drewsum/Stopwatch/README.md

# Stopwatch
Hardware stopwatch, no code or microcontroller. 

"Display Enable" pushbutton toggles the seven segment LED display on and off
"Count Reset" pushbutton resets the counted time back to 00:00:00
"Count Enable" pushbutton starts and stops the stopwatch
