drewsum/Stopwatch/hdw/rev_b/Stopwatch/Stopwatch-BOM.xlsx

Reference | Value | Datasheet | Footprint | Qty | DNP | Config | Digi-Key PN
C201,C303,C402,C601,C602,C603 | 10nF |  | Capacitors_SMD:C_0402 | 6 |  |  | 445-12201-1-ND
C202,C304,C401,C404,C405,C406,C501,C502,C503,C504,C505,C604,C605,C606,C610,C611,C612,C613,C614,C701,C801,C901,C1001,C1101,C1201,C1301,C1302,C1303,C1304,C1305,C1306,C1307,C1401,C1402,C1403,C1404,C1405,C1406,C1407 | 0.1uF |  | Capacitors_SMD:C_0402 | 39 |  |  | 490-10697-1-ND
C203 | 100uF |  | Capacitor_Tantalum_SMD:CP_EIA-7343-43_Kemet-X | 1 |  |  | 718-1102-1-ND
C301,C305,C306 | 10uF |  | Capacitors_SMD:C_1206 | 3 |  |  | 1276-7031-1-ND
C302,C607,C608,C609 | 10uF |  | Capacitors_SMD:C_0402 | 4 |  |  | 490-GRM155R61A106ME11DCT-ND
C403 | 1nF |  | Capacitors_SMD:C_0402 | 1 |  |  | 445-7376-1-ND
D201 | 24V | ~ | Diodes_SMD:D_SMA | 1 | DNP | DNP | SMAJ24CALFCT-ND
D301 | BAT48JFILM | www.st.com/resource/en/datasheet/bat48.pdf | Diode_SMD:D_SOD-323 | 1 |  |  | 497-5711-1-ND
D501,D504,D505 | Green | ~ | LEDs:LED_0402 | 3 |  |  | 754-1101-1-ND
D502,D503,D506,D507 | Red | ~ | LEDs:LED_0402 | 4 |  |  | 754-1104-1-ND
H1501,H1502,H1503,H1504 | 3mm | ~ | MountingHole:MountingHole_3mm | 4
J201 | +12V IN | ~ | Connectors:BARREL_JACK | 1 |  |  | CP-202BH-ND
L301 | 2.2u |  | Inductors_SMD:L_Vishay_IHLP-2020 | 1 |  |  | 541-1236-1-ND
N201 | +12V 1A Power Supply | ~ |  | 1 |  |  | 993-1335-ND
Q301 | BSS214NW | https://www.infineon.com/dgdl/Infineon-BSS214NW-DS-v02_02-en.pdf?fileId=db3a30431b3e89eb011b695aebc01bde | Package_TO_SOT_SMD:SOT-323_SC-70 | 1 |  |  | BSS214NWH6327XTSA1CT-ND
Q302 | ZXMS6004FFTA | https://www.diodes.com/assets/Datasheets/ZXMS6004FF.pdf | Package_TO_SOT_SMD:SOT-23 | 1 |  |  | ZXMS6004FFCT-ND
R201 | 51.1k |  | Resistors_SMD:R_0402 | 1 |  |  | RMCF0402FT51K1CT-ND
R202 | 1.15k |  | Resistors_SMD:R_0402 | 1 |  |  | RMCF0402FT1K15CT-ND
R203,R207 | 5.11k |  | Resistors_SMD:R_0402 | 2 |  |  | RMCF0402FT5K11CT-ND
R204,R205,R208,R302,R303,R401,R402,R403,R404,R405,R406,R607,R608,R609,R610,R611,R612,R613,R614,R615,R616,R617,R701,R801,R901,R1001,R1101,R1201,R1301,R1302,R1303,R1304,R1305,R1306,R1307,R1401,R1402,R1403,R1404,R1405,R1406,R1407 | 10k |  | Resistors_SMD:R_0402 | 42 |  |  | RMCF0402FT10K0CT-ND
R206 | 13k |  | Resistors_SMD:R_0402 | 1 |  |  | RMCF0402FT13K0CT-ND
R301 | 10 |  | Resistors_SMD:R_0402 | 1 |  |  | RMCF0402FT10R0CT-ND
R304 | 562k |  | Resistors_SMD:R_0402 | 1 |  |  | RMCF0402FT562KCT-ND
R305 | 180k |  | Resistors_SMD:R_0402 | 1 |  |  | RMCF0402FT180KCT-ND
R501,R502,R503,R504,R505,R506,R507,R601,R602,R603,R604,R605,R606 | 1k |  | Resistors_SMD:R_0402 | 13 |  |  | RMCF0402FT1K00CT-ND
RN701,RN801,RN901,RN1001,RN1101,RN1201 | 1k |  | Resistor_SMD:R_Cat16-8 | 6 |  |  | CAT16-102J8LFCT-ND
SW601,SW602,SW603 | Cap_Touch |  | Custom Footprints Library:Capacitive_Touch_Pad | 3
TP201 | TP |  | Connector_PinHeader_2.54mm:PinHeader_1x01_P2.54mm_Horizontal | 1
TP202,TP203 | TP_Pad |  | Custom Footprints Library:Test_Point | 2
TP301 | TP |  | Custom Footprints Library:Test_Point | 1
U201 | TPS26600RHFT | http://www.ti.com/lit/ds/symlink/tps2660.pdf | Housings_DFN_QFN:QFN-24-1EP_4x5mm_Pitch0.5mm | 1 |  |  | 296-45478-1-ND
U301 | TPS62130A | http://www.ti.com/lit/ds/symlink/tps62130.pdf | Housings_DFN_QFN:QFN-16-1EP_3x3mm_Pitch0.5mm | 1 |  |  | 296-39446-1-ND
U401,U501,U502,U503,U504,U505,U604,U605,U606,U1301,U1302,U1303,U1304,U1305,U1306,U1307,U1401,U1402,U1403,U1404,U1405,U1406,U1407 | 74LVC1G97 | http://www.ti.com/lit/ds/symlink/sn74lvc1g97.pdf | Package_TO_SOT_SMD:SOT-363_SC-70-6 | 23 |  |  | 296-15582-1-ND
U402 | CD4024 | http://www.ti.com/lit/ds/symlink/cd4020b.pdf | Housings_SSOP:TSSOP-14_4.4x5mm_Pitch0.65mm | 1 |  |  | 296-49578-ND
U403 | CD4040 | http://www.intersil.com/content/dam/Intersil/documents/cd40/cd4020bms-24bms-40bms.pdf | Custom Footprints Library:DHVQFN16-1ep_3p5x2p5mm | 1 |  |  | 1727-7992-1-ND
U601,U602,U603 | AT42QT1010-TSHR | http://ww1.microchip.com/downloads/en/DeviceDoc/Atmel-9541-AT42-QTouch-BSW-AT42QT1010_Datasheet.pdf | TO_SOT_Packages_SMD:SOT-23-6 | 3 |  |  | AT42QT1010-TSHRCT-ND
U607,U608 | 74LVC1G80 | http://www.ti.com/lit/sg/scyt129e/scyt129e.pdf | Package_TO_SOT_SMD:SOT-353_SC-70-5 | 2 |  |  | 296-41824-1-ND
U701,U801,U901,U1001,U1101,U1201 | 4026 |  | Housings_SSOP:TSSOP-16_4.4x5mm_Pitch0.65mm | 6 |  |  | 296-32878-5-ND
U702,U802,U902,U1002,U1102,U1202 | HDSP-7503 | https://docs.broadcom.com/docs/AV02-2553EN | Display_7Segment:HDSP-A151 | 6 |  |  | 516-1203-5-ND
X401 | ECS-327KE |  | Oscillator:Oscillator_SMD_Abracon_ASE-4Pin_3.2x2.5mm | 1 |  |  | XC1751CT-ND
