drewsum/Stopwatch/hdw/rev_a/Stopwatch/Stopwatch.pdf

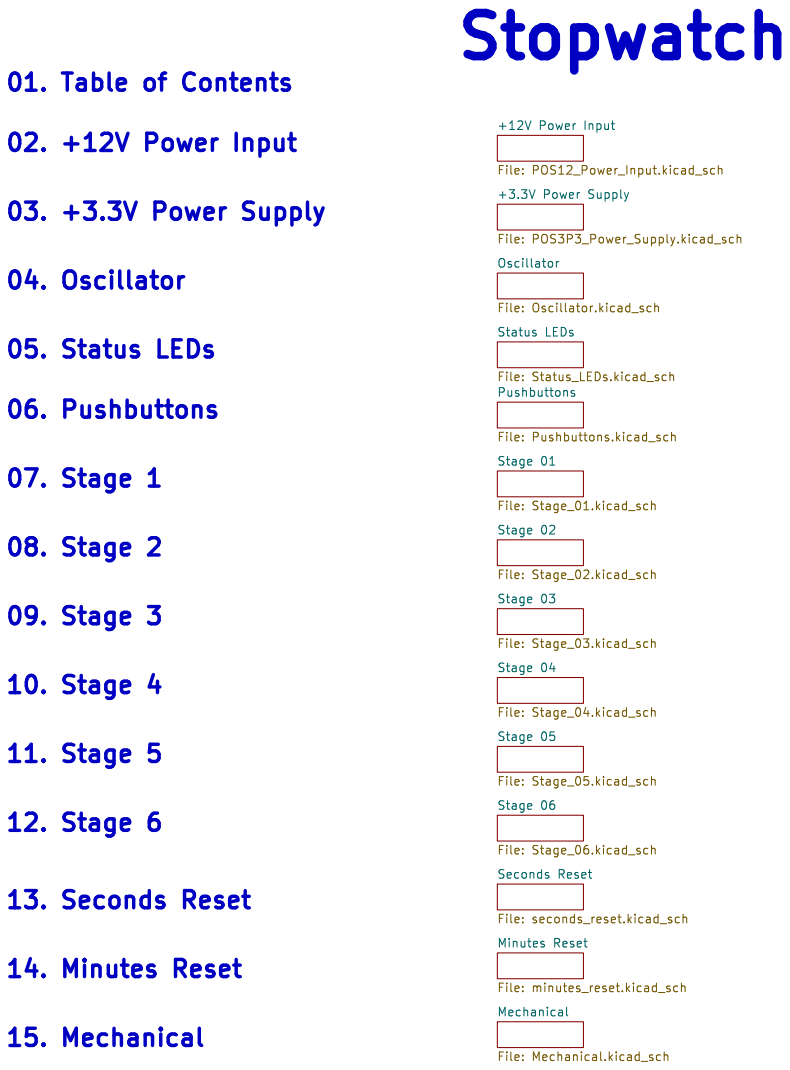
[picture p1: page 1]

Stage 01 File: Stage_01.kicad_sch Status LEDs File: Status_LEDs.kicad_sch Pushbuttons File: Pushbuttons.kicad_sch +3.3V Power Supply File: POS3P3_Power_Supply.kicad_sch +12V Power Input File: POS12_Power_Input.kicad_sch Oscillator File: Oscillator.kicad_sch Stage 02 File: Stage_02.kicad_sch

Stage 06 File: Stage_06.kicad_sch Mechanical File: Mechanical.kicad_sch Minutes Reset File: minutes_reset.kicad_sch Seconds Reset File: seconds_reset.kicad_sch 12. Stage 6

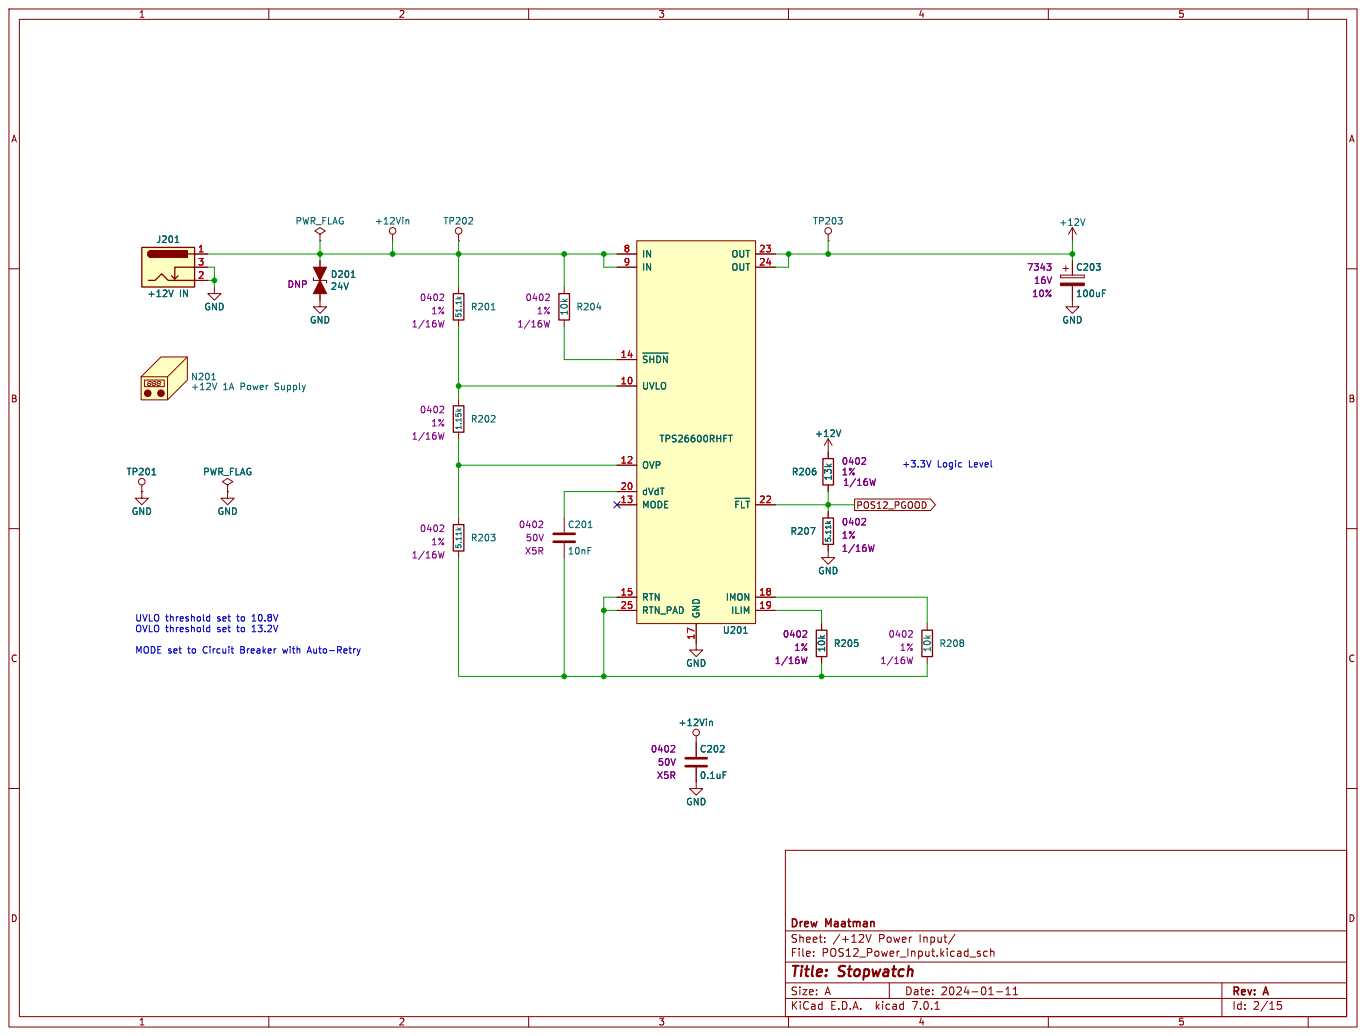
[picture p2: page 2]

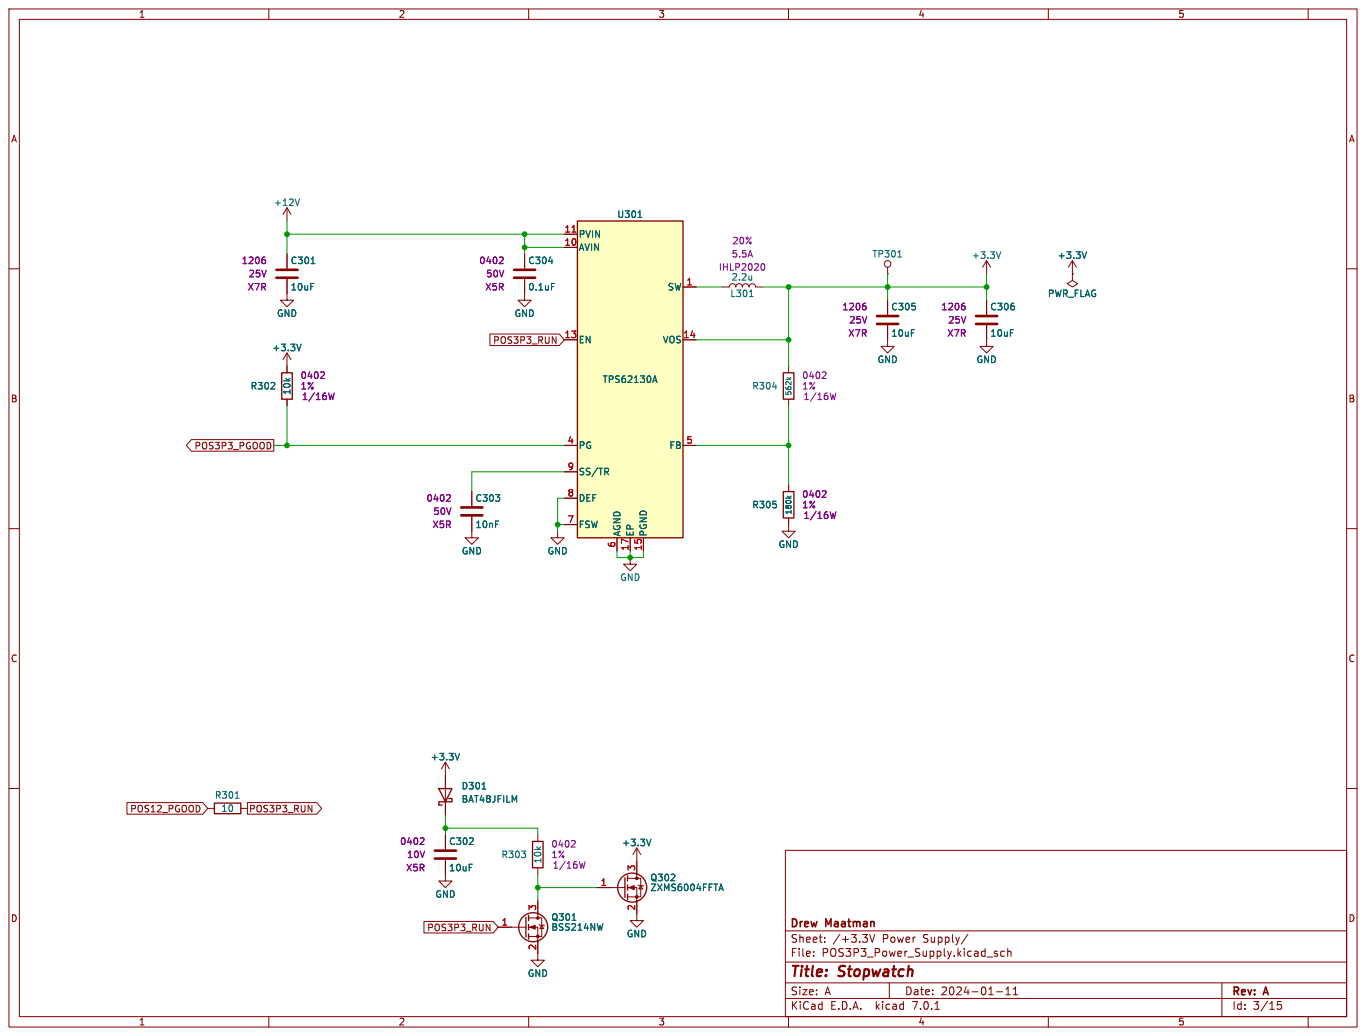
[picture p3: page 3]

6 FSW 7 DEF 8 SS/TR 9 U301 TPS62130A

6 FSW 7 DEF 8 SS/TR 9 C306

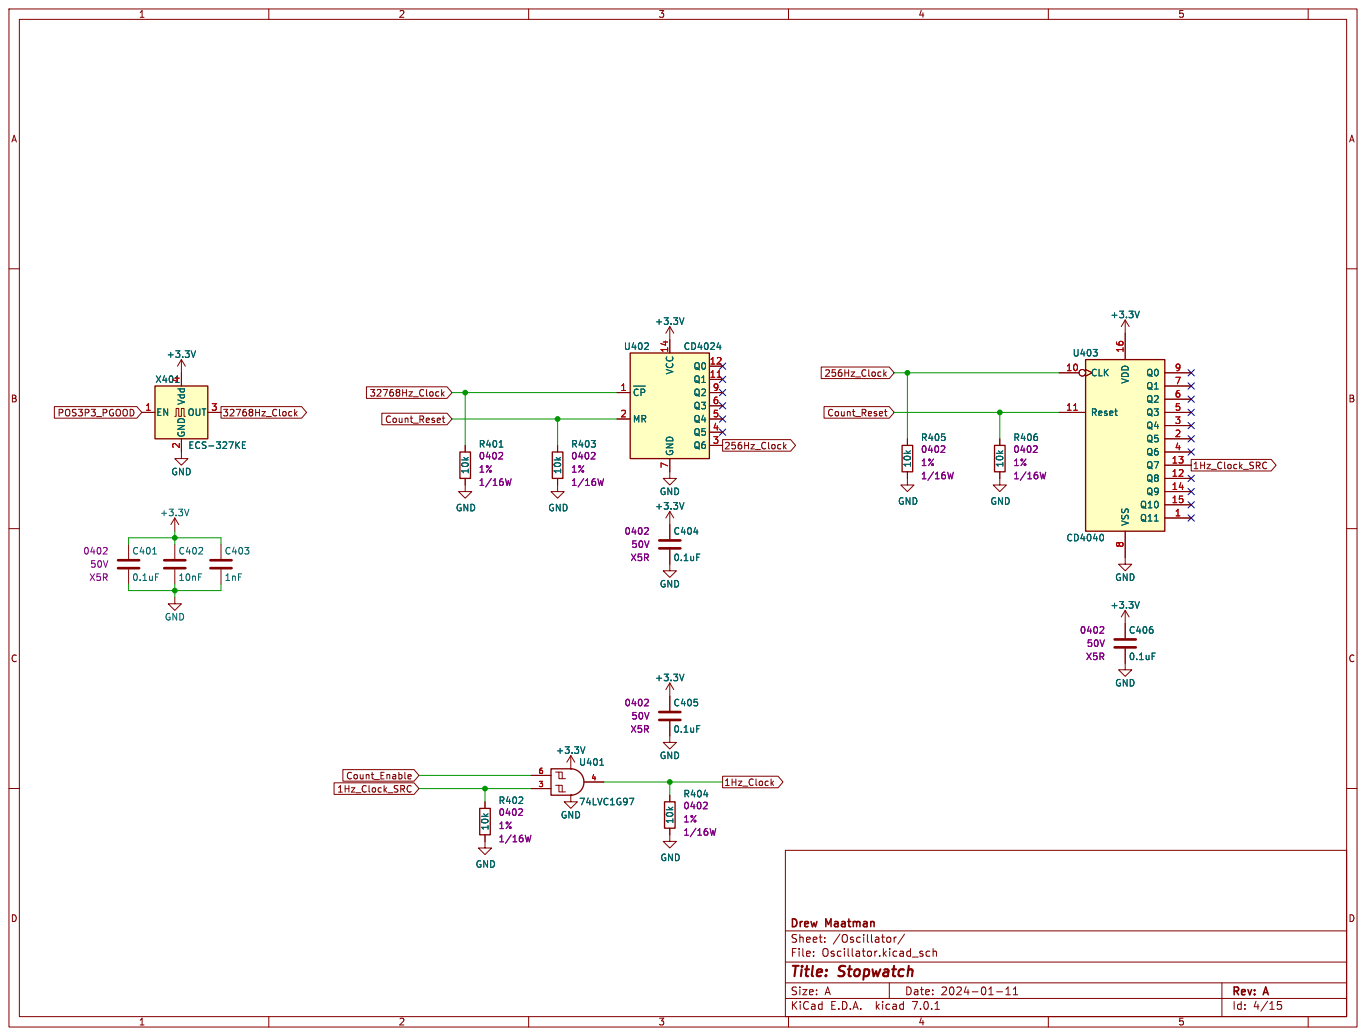
[picture p4: page 4]

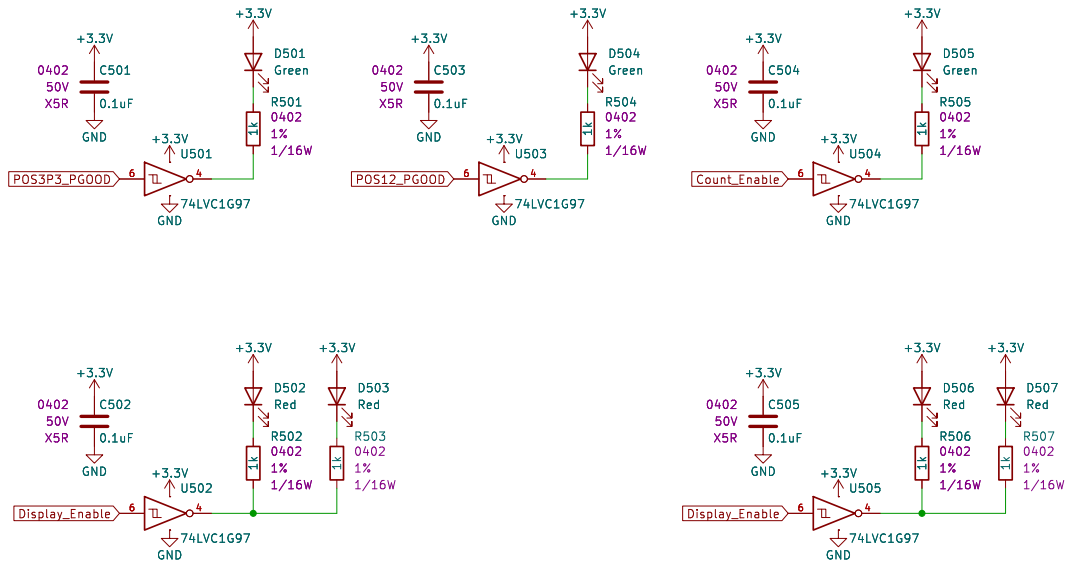
[picture p5: page 5]

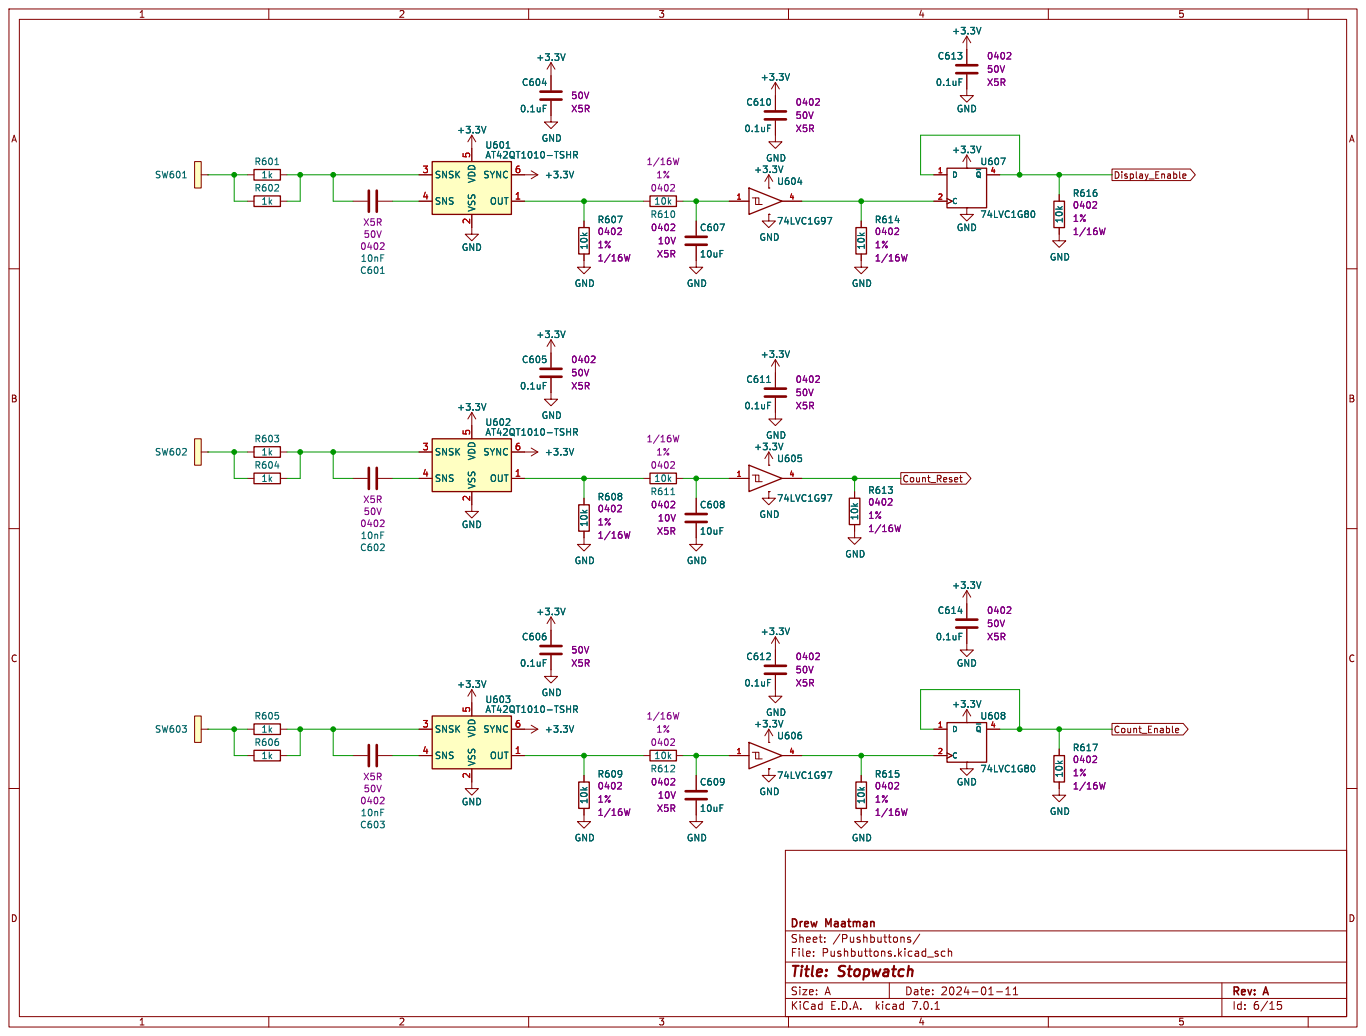
[picture p6: page 6]

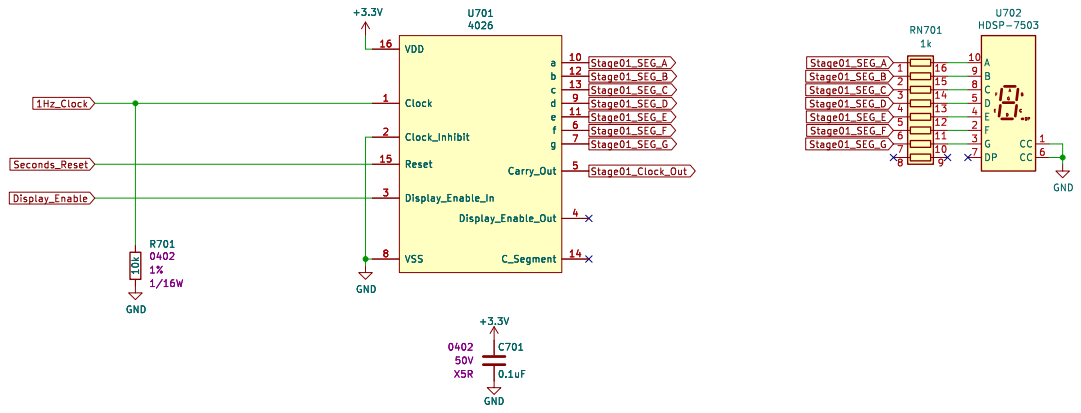
[picture p7: page 7]

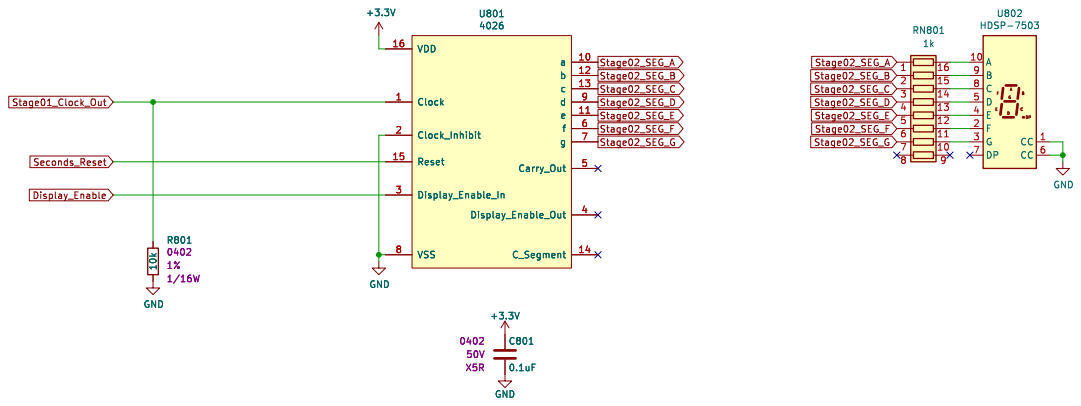
[picture p8: page 8]

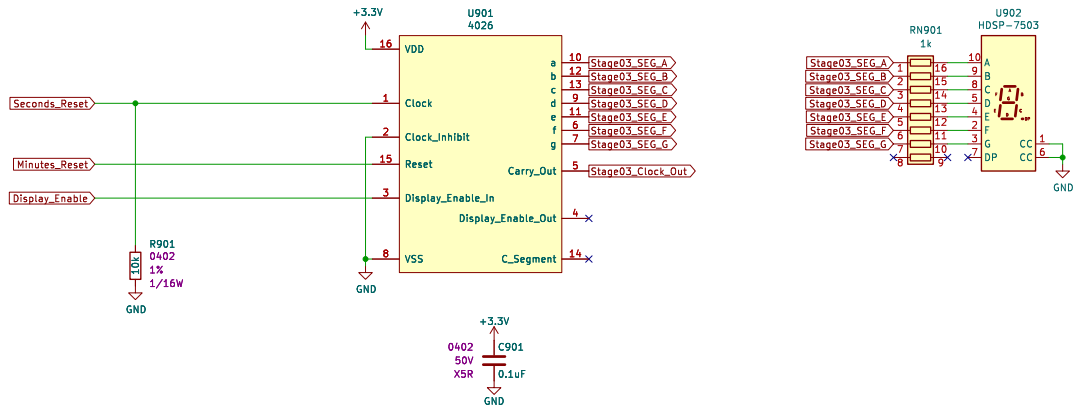
[picture p9: page 9]

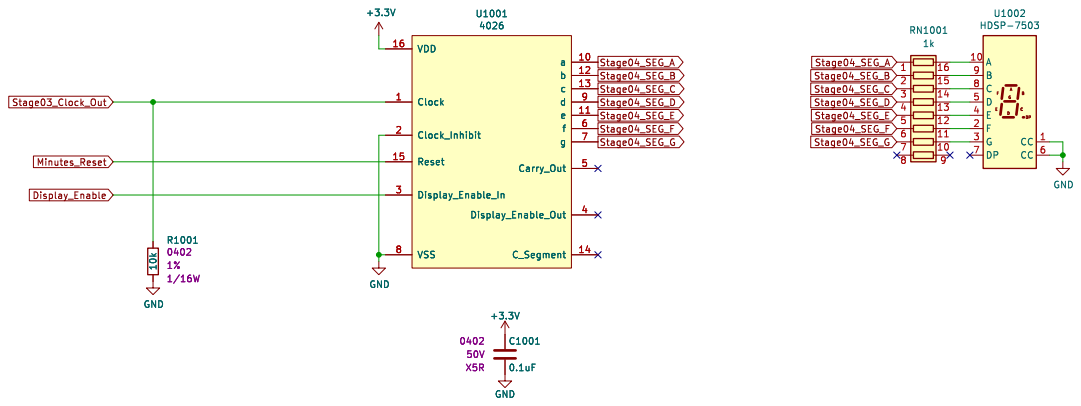
[picture p10: page 10]

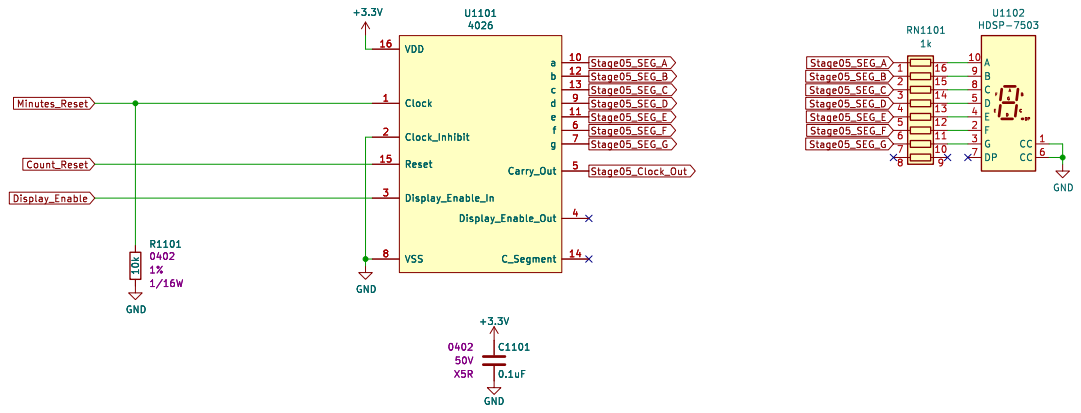
[picture p11: page 11]

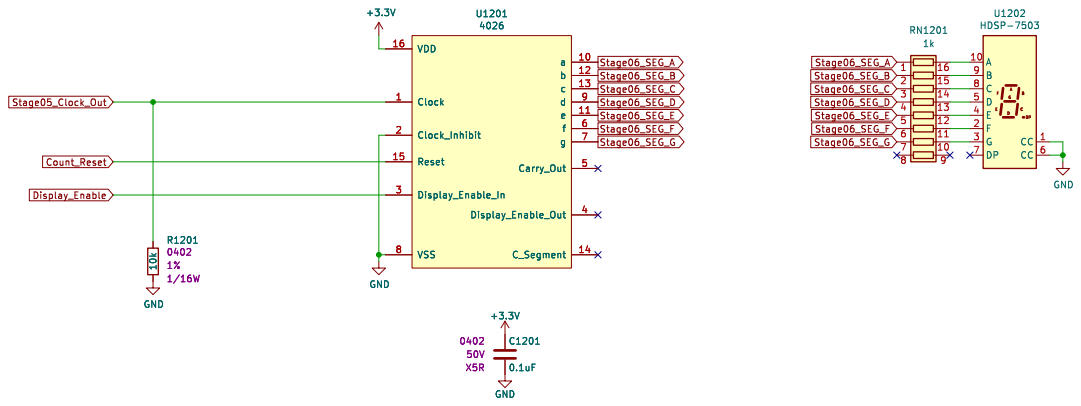
[picture p12: page 12]

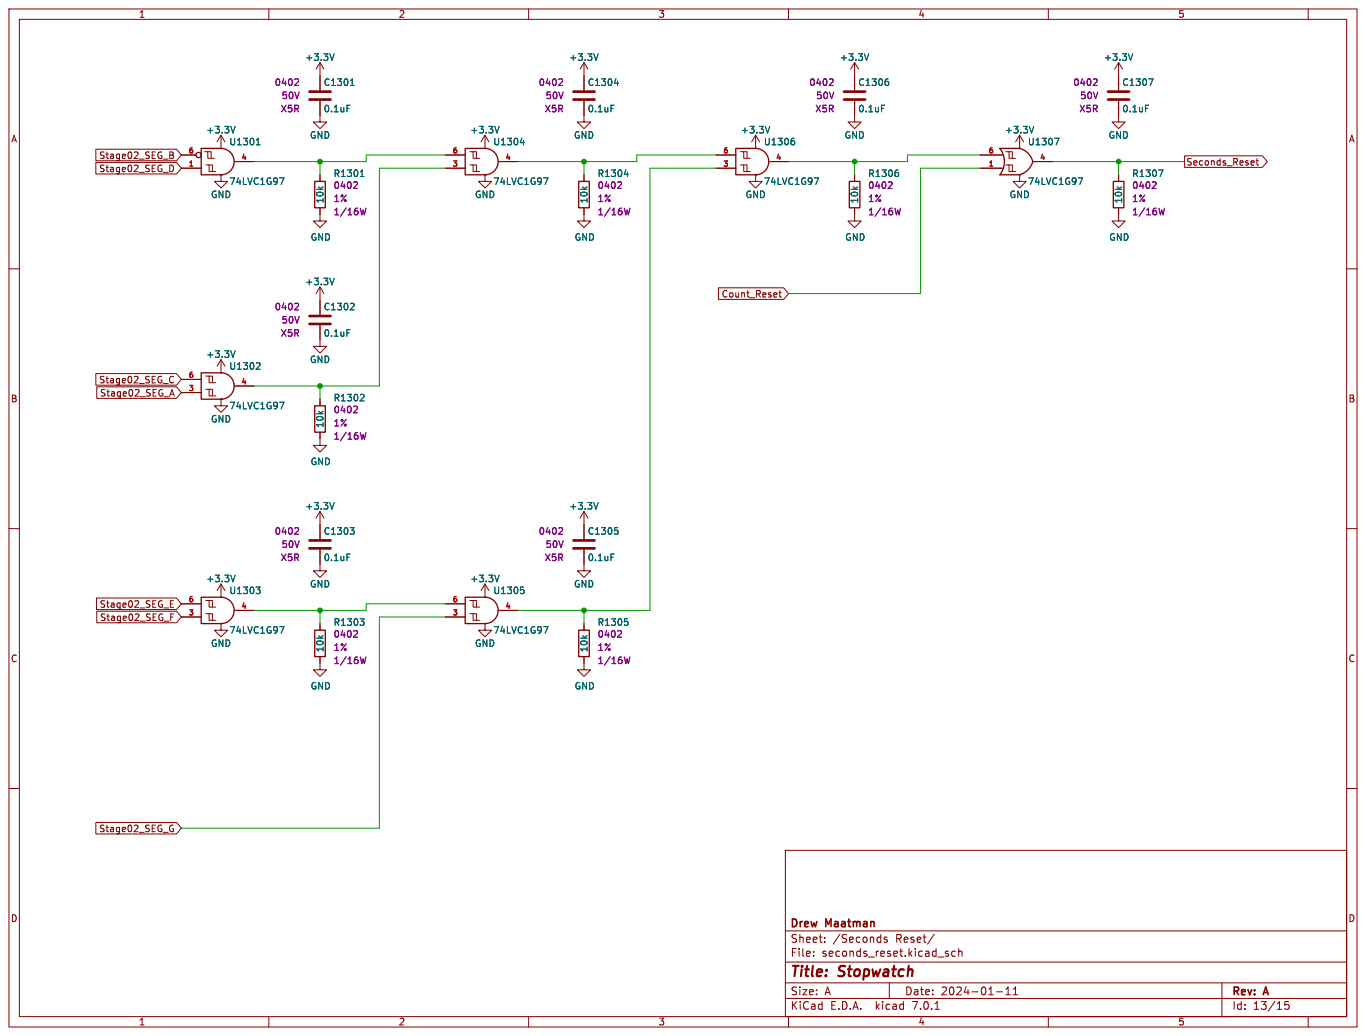
[picture p13: page 13]

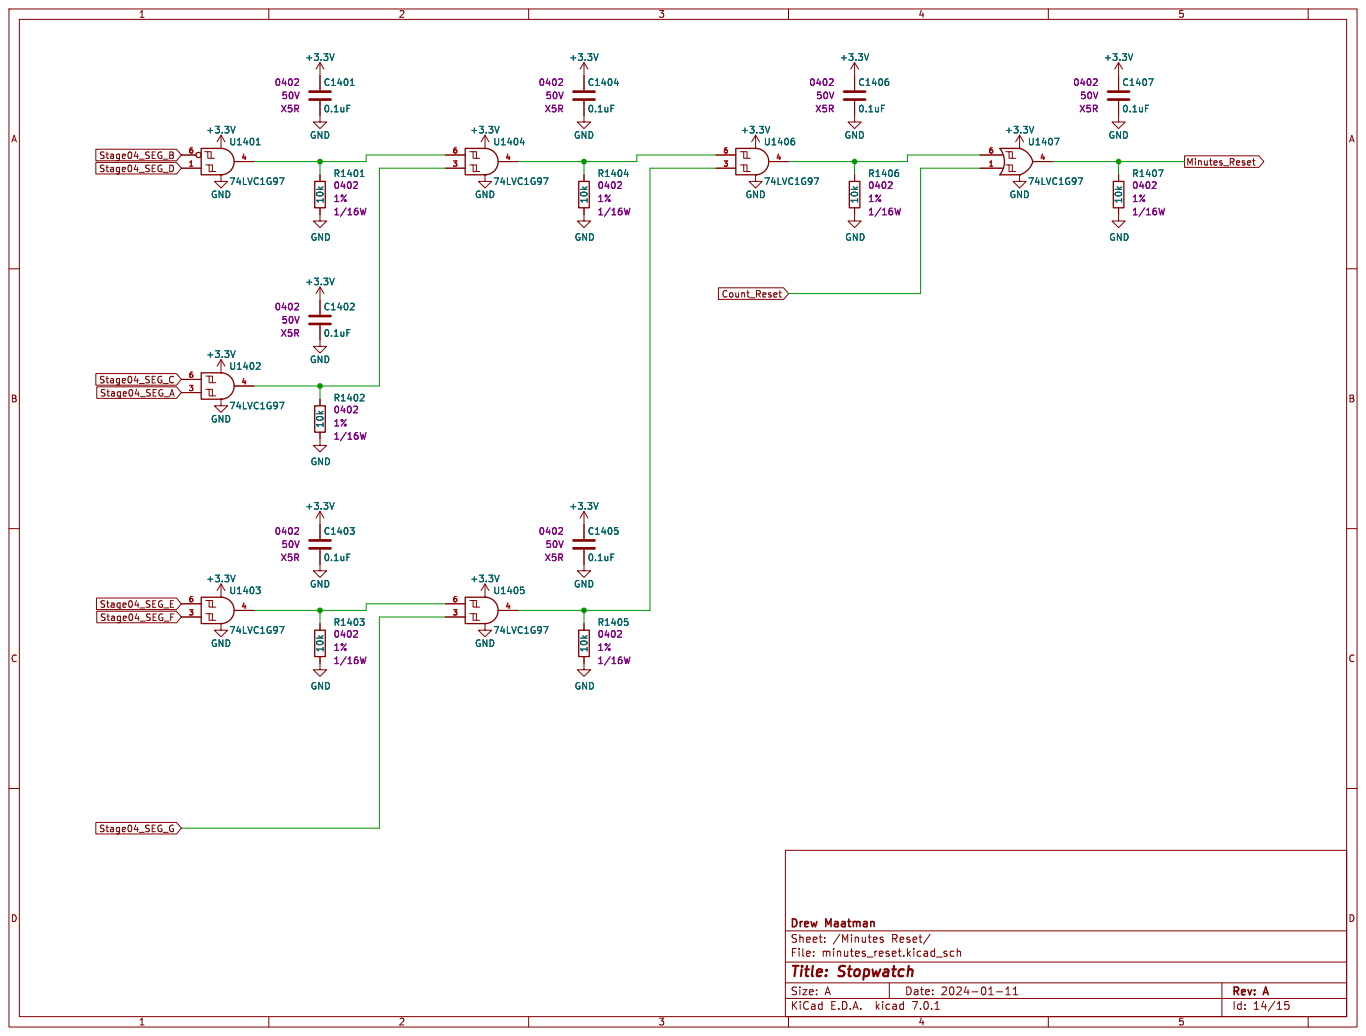
[picture p14: page 14]

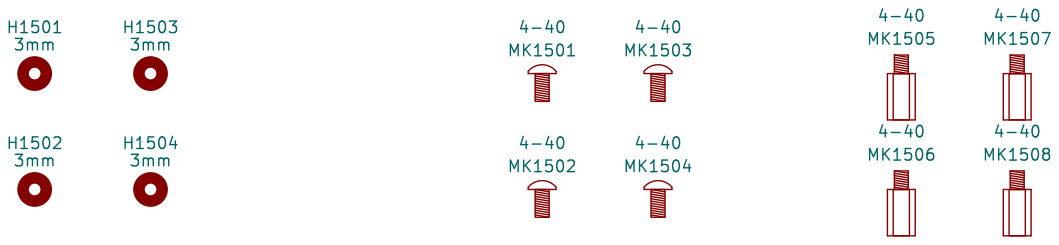
[picture p15: page 15]
