drewsum/Stopwatch/hdw/rev_a/Stopwatch/Stopwatch.kicad_pcb

## KiCad design hdw/rev_a/Stopwatch/Stopwatch.kicad_pcb (2024-02-03, an earlier design)

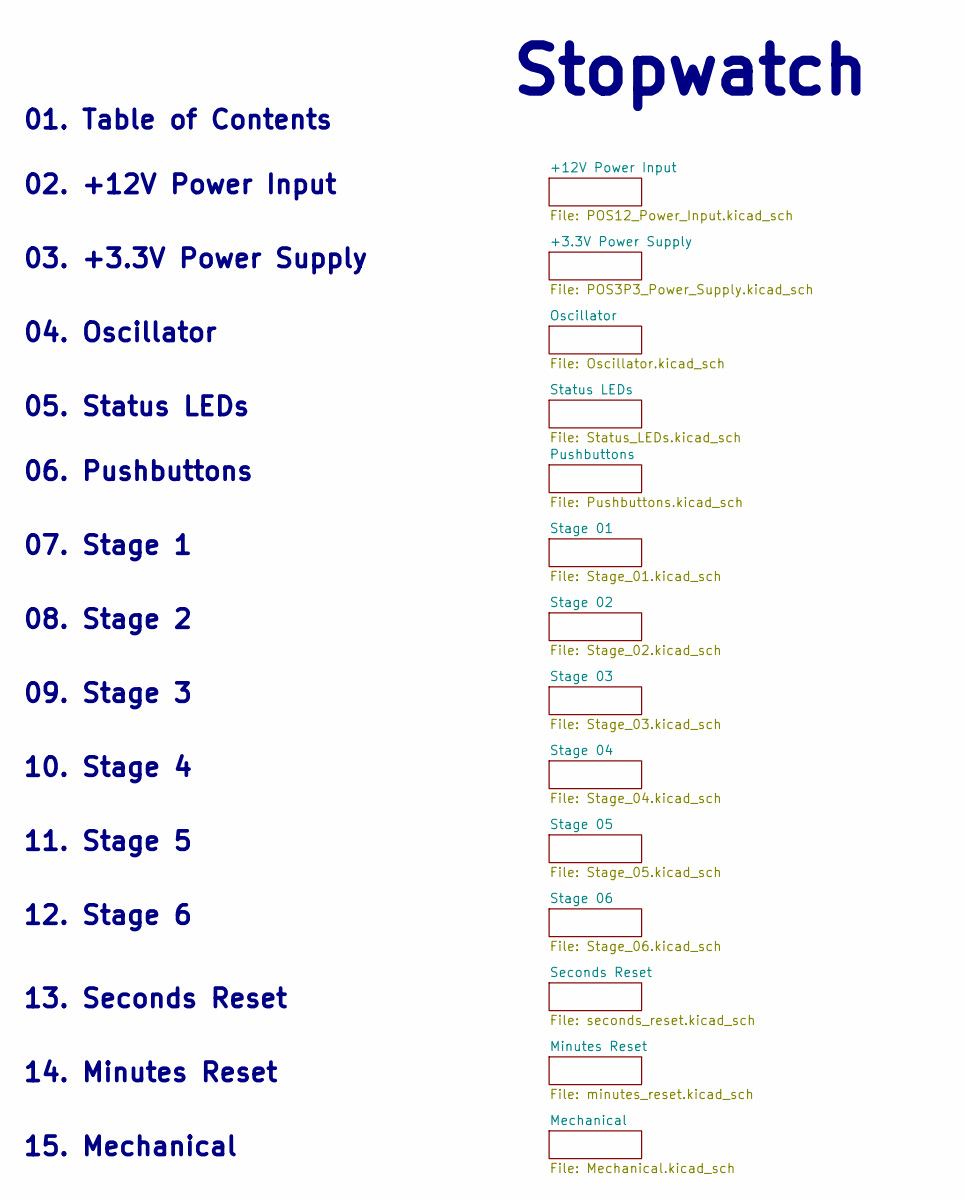
[picture p16: schematic Stopwatch.kicad_sch]

Notes on the sheet:
12. Stage 6
09. Stage 3
05. Status LEDs
10. Stage 4
15. Mechanical
Stopwatch
03. +3.3V Power Supply
01. Table of Contents
14. Minutes Reset
08. Stage 2
06. Pushbuttons
02. +12V Power Input
07. Stage 1
11. Stage 5
13. Seconds Reset
04. Oscillator

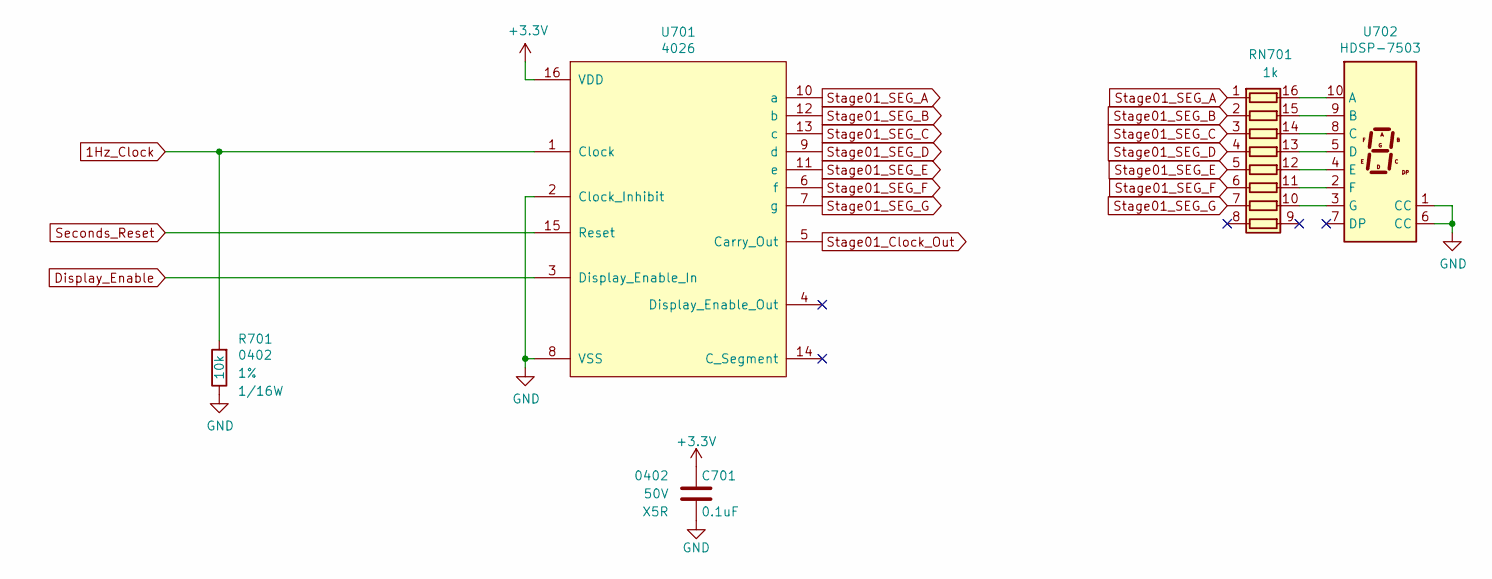
[picture p17: schematic Stage_01.kicad_sch, Stopwatch]

Parts:
C701: 0.1uF; C_0402; Voltage 50V; Digi-Key PN 490-10697-1-ND
R701: 10k; R_0402; Tolerance 1%; Digi-Key PN RMCF0402FT10K0CT-ND
RN701: 1k; R_Cat16-8; Digi-Key PN CAT16-102J8LFCT-ND
U701: 4026; TSSOP-16_4.4x5mm_Pitch0.65mm; Digi-Key PN 296-32878-5-ND
U702: HDSP-7503; HDSP-A151; Digi-Key PN 516-1203-5-ND

Connections:
1Hz_Clock: R701.1, U701.1 (Clock); also elsewhere on the board
+3.3V: C701.1, U701.16 (VDD); also elsewhere on the board
Display_Enable: U701.3 (Display_Enable_In); also elsewhere on the board
GND: C701.2, R701.2, U701.2 (Clock_Inhibit), U701.8 (VSS), U702.1 (CC), U702.6 (CC); also elsewhere on the board
unnamed: RN701.16 (R1.2), U702.10 (A)
unnamed: RN701.15 (R2.2), U702.9 (B)
unnamed: RN701.14 (R3.2), U702.8 (C)
unnamed: RN701.13 (R4.2), U702.5 (D)
unnamed: RN701.12 (R5.2), U702.4 (E)
unnamed: RN701.11 (R6.2), U702.2 (F)
unnamed: RN701.10 (R7.2), U702.3 (G)
Seconds_Reset: U701.15 (Reset); also elsewhere on the board
Stage01_Clock_Out: U701.5 (Carry_Out); also elsewhere on the board
Stage01_SEG_A: RN701.1 (R1.1), U701.10 (a)
Stage01_SEG_B: RN701.2 (R2.1), U701.12 (b)
Stage01_SEG_C: RN701.3 (R3.1), U701.13 (c)
Stage01_SEG_D: RN701.4 (R4.1), U701.9 (d)
Stage01_SEG_E: RN701.5 (R5.1), U701.11 (e)
Stage01_SEG_F: RN701.6 (R6.1), U701.6 (f)
Stage01_SEG_G: RN701.7 (R7.1), U701.7 (g)

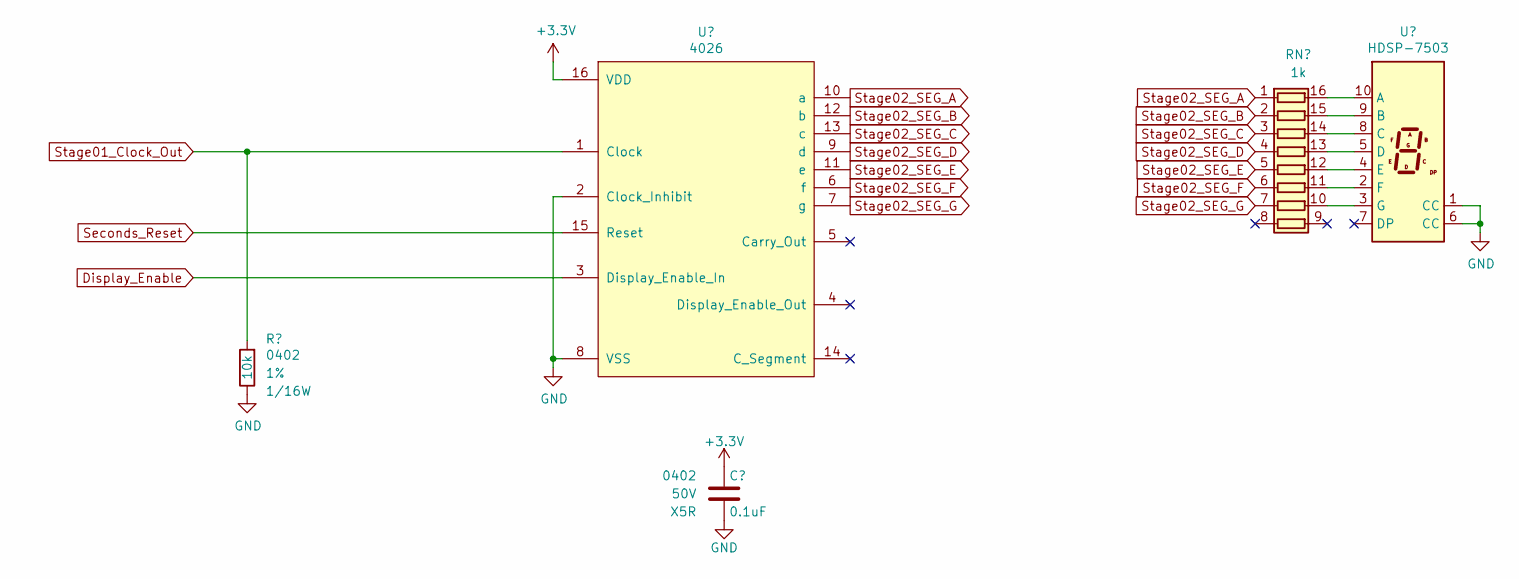
[picture p18: schematic Stage_02.kicad_sch, Stopwatch]

Parts:
C801: 0.1uF; C_0402; Voltage 50V; Digi-Key PN 490-10697-1-ND
R801: 10k; R_0402; Tolerance 1%; Digi-Key PN RMCF0402FT10K0CT-ND
RN801: 1k; R_Cat16-8; Digi-Key PN CAT16-102J8LFCT-ND
U801: 4026; TSSOP-16_4.4x5mm_Pitch0.65mm; Digi-Key PN 296-32878-5-ND
U802: HDSP-7503; HDSP-A151; Digi-Key PN 516-1203-5-ND

Connections:
+3.3V: C801.1, U801.16 (VDD); also elsewhere on the board
Display_Enable: U801.3 (Display_Enable_In); also elsewhere on the board
GND: C801.2, R801.2, U801.2 (Clock_Inhibit), U801.8 (VSS), U802.1 (CC), U802.6 (CC); also elsewhere on the board
unnamed: RN801.16 (R1.2), U802.10 (A)
unnamed: RN801.15 (R2.2), U802.9 (B)
unnamed: RN801.14 (R3.2), U802.8 (C)
unnamed: RN801.13 (R4.2), U802.5 (D)
unnamed: RN801.12 (R5.2), U802.4 (E)
unnamed: RN801.11 (R6.2), U802.2 (F)
unnamed: RN801.10 (R7.2), U802.3 (G)
Seconds_Reset: U801.15 (Reset); also elsewhere on the board
Stage01_Clock_Out: R801.1, U801.1 (Clock); also elsewhere on the board
Stage02_SEG_A: RN801.1 (R1.1), U801.10 (a); also elsewhere on the board
Stage02_SEG_B: RN801.2 (R2.1), U801.12 (b); also elsewhere on the board
Stage02_SEG_C: RN801.3 (R3.1), U801.13 (c); also elsewhere on the board
Stage02_SEG_D: RN801.4 (R4.1), U801.9 (d); also elsewhere on the board
Stage02_SEG_E: RN801.5 (R5.1), U801.11 (e); also elsewhere on the board
Stage02_SEG_F: RN801.6 (R6.1), U801.6 (f); also elsewhere on the board
Stage02_SEG_G: RN801.7 (R7.1), U801.7 (g); also elsewhere on the board

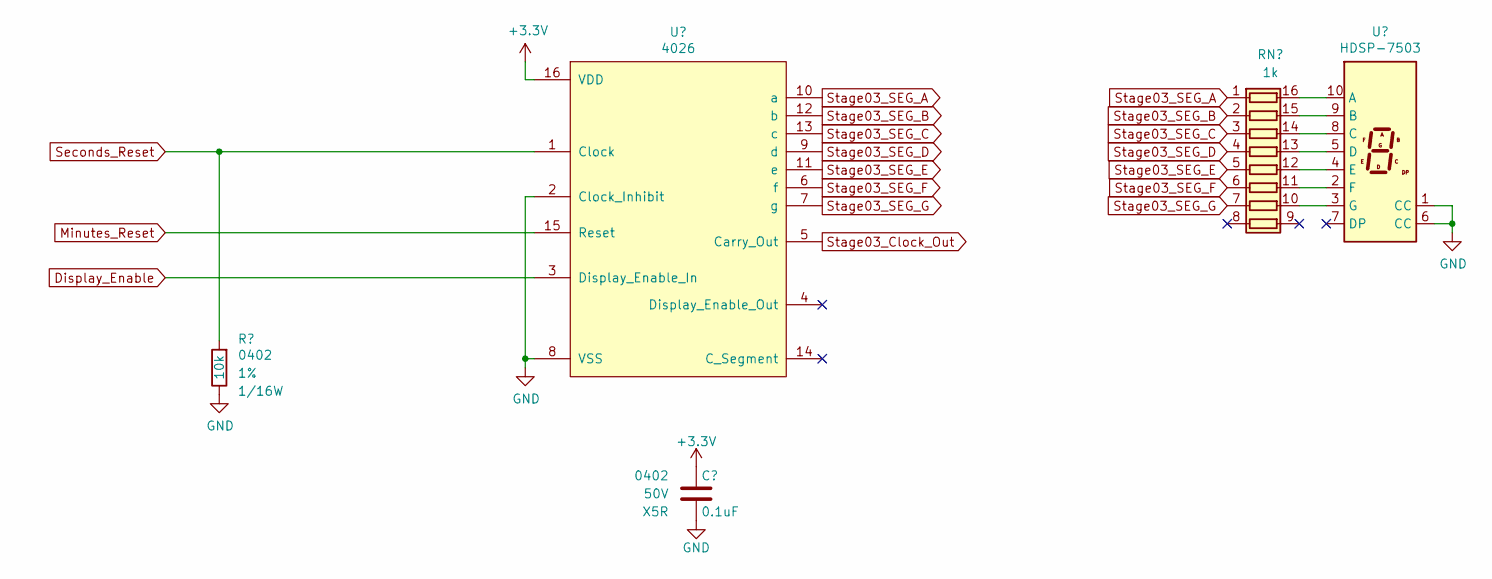
[picture p19: schematic Stage_03.kicad_sch, Stopwatch]

Parts:
C901: 0.1uF; C_0402; Voltage 50V; Digi-Key PN 490-10697-1-ND
R901: 10k; R_0402; Tolerance 1%; Digi-Key PN RMCF0402FT10K0CT-ND
RN901: 1k; R_Cat16-8; Digi-Key PN CAT16-102J8LFCT-ND
U901: 4026; TSSOP-16_4.4x5mm_Pitch0.65mm; Digi-Key PN 296-32878-5-ND
U902: HDSP-7503; HDSP-A151; Digi-Key PN 516-1203-5-ND

Connections:
+3.3V: C901.1, U901.16 (VDD); also elsewhere on the board
Display_Enable: U901.3 (Display_Enable_In); also elsewhere on the board
GND: C901.2, R901.2, U901.2 (Clock_Inhibit), U901.8 (VSS), U902.1 (CC), U902.6 (CC); also elsewhere on the board
Minutes_Reset: U901.15 (Reset); also elsewhere on the board
unnamed: RN901.16 (R1.2), U902.10 (A)
unnamed: RN901.15 (R2.2), U902.9 (B)
unnamed: RN901.14 (R3.2), U902.8 (C)
unnamed: RN901.13 (R4.2), U902.5 (D)
unnamed: RN901.12 (R5.2), U902.4 (E)
unnamed: RN901.11 (R6.2), U902.2 (F)
unnamed: RN901.10 (R7.2), U902.3 (G)
Seconds_Reset: R901.1, U901.1 (Clock); also elsewhere on the board
Stage03_Clock_Out: U901.5 (Carry_Out); also elsewhere on the board
Stage03_SEG_A: RN901.1 (R1.1), U901.10 (a)
Stage03_SEG_B: RN901.2 (R2.1), U901.12 (b)
Stage03_SEG_C: RN901.3 (R3.1), U901.13 (c)
Stage03_SEG_D: RN901.4 (R4.1), U901.9 (d)
Stage03_SEG_E: RN901.5 (R5.1), U901.11 (e)
Stage03_SEG_F: RN901.6 (R6.1), U901.6 (f)
Stage03_SEG_G: RN901.7 (R7.1), U901.7 (g)

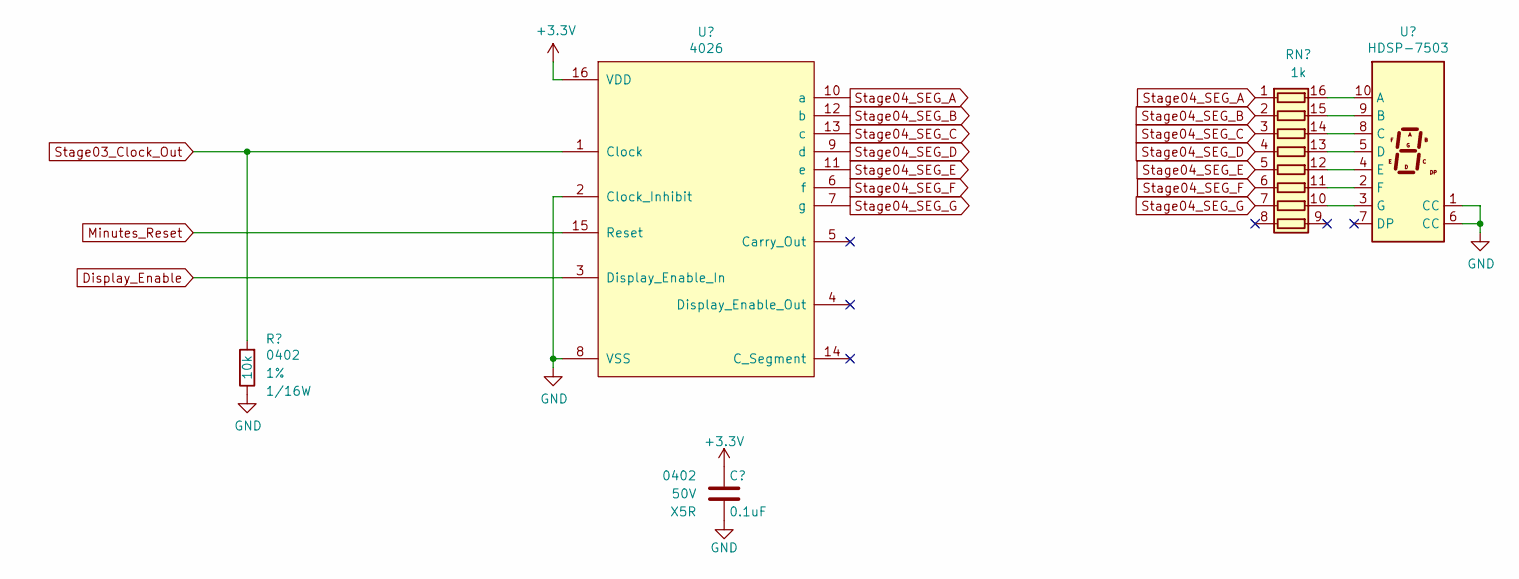
[picture p20: schematic Stage_04.kicad_sch, Stopwatch]

Parts:
C1001: 0.1uF; C_0402; Voltage 50V; Digi-Key PN 490-10697-1-ND
R1001: 10k; R_0402; Tolerance 1%; Digi-Key PN RMCF0402FT10K0CT-ND
RN1001: 1k; R_Cat16-8; Digi-Key PN CAT16-102J8LFCT-ND
U1001: 4026; TSSOP-16_4.4x5mm_Pitch0.65mm; Digi-Key PN 296-32878-5-ND
U1002: HDSP-7503; HDSP-A151; Digi-Key PN 516-1203-5-ND

Connections:
+3.3V: C1001.1, U1001.16 (VDD); also elsewhere on the board
Display_Enable: U1001.3 (Display_Enable_In); also elsewhere on the board
GND: C1001.2, R1001.2, U1001.2 (Clock_Inhibit), U1001.8 (VSS), U1002.1 (CC), U1002.6 (CC); also elsewhere on the board
Minutes_Reset: U1001.15 (Reset); also elsewhere on the board
unnamed: RN1001.16 (R1.2), U1002.10 (A)
unnamed: RN1001.15 (R2.2), U1002.9 (B)
unnamed: RN1001.14 (R3.2), U1002.8 (C)
unnamed: RN1001.13 (R4.2), U1002.5 (D)
unnamed: RN1001.12 (R5.2), U1002.4 (E)
unnamed: RN1001.11 (R6.2), U1002.2 (F)
unnamed: RN1001.10 (R7.2), U1002.3 (G)
Stage03_Clock_Out: R1001.1, U1001.1 (Clock); also elsewhere on the board
Stage04_SEG_A: RN1001.1 (R1.1), U1001.10 (a); also elsewhere on the board
Stage04_SEG_B: RN1001.2 (R2.1), U1001.12 (b); also elsewhere on the board
Stage04_SEG_C: RN1001.3 (R3.1), U1001.13 (c); also elsewhere on the board
Stage04_SEG_D: RN1001.4 (R4.1), U1001.9 (d); also elsewhere on the board
Stage04_SEG_E: RN1001.5 (R5.1), U1001.11 (e); also elsewhere on the board
Stage04_SEG_F: RN1001.6 (R6.1), U1001.6 (f); also elsewhere on the board
Stage04_SEG_G: RN1001.7 (R7.1), U1001.7 (g); also elsewhere on the board

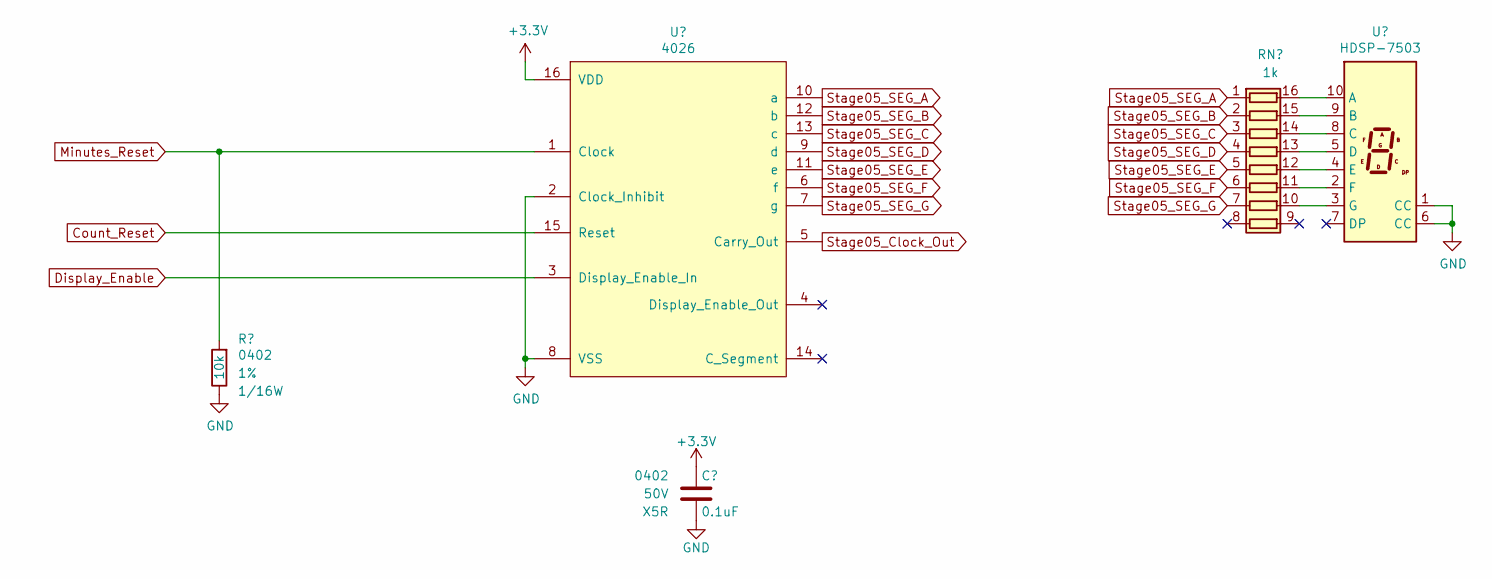
[picture p21: schematic Stage_05.kicad_sch, Stopwatch]

Parts:
C1101: 0.1uF; C_0402; Voltage 50V; Digi-Key PN 490-10697-1-ND
R1101: 10k; R_0402; Tolerance 1%; Digi-Key PN RMCF0402FT10K0CT-ND
RN1101: 1k; R_Cat16-8; Digi-Key PN CAT16-102J8LFCT-ND
U1101: 4026; TSSOP-16_4.4x5mm_Pitch0.65mm; Digi-Key PN 296-32878-5-ND
U1102: HDSP-7503; HDSP-A151; Digi-Key PN 516-1203-5-ND

Connections:
+3.3V: C1101.1, U1101.16 (VDD); also elsewhere on the board
Count_Reset: U1101.15 (Reset); also elsewhere on the board
Display_Enable: U1101.3 (Display_Enable_In); also elsewhere on the board
GND: C1101.2, R1101.2, U1101.2 (Clock_Inhibit), U1101.8 (VSS), U1102.1 (CC), U1102.6 (CC); also elsewhere on the board
Minutes_Reset: R1101.1, U1101.1 (Clock); also elsewhere on the board
unnamed: RN1101.16 (R1.2), U1102.10 (A)
unnamed: RN1101.15 (R2.2), U1102.9 (B)
unnamed: RN1101.14 (R3.2), U1102.8 (C)
unnamed: RN1101.13 (R4.2), U1102.5 (D)
unnamed: RN1101.12 (R5.2), U1102.4 (E)
unnamed: RN1101.11 (R6.2), U1102.2 (F)
unnamed: RN1101.10 (R7.2), U1102.3 (G)
Stage05_Clock_Out: U1101.5 (Carry_Out); also elsewhere on the board
Stage05_SEG_A: RN1101.1 (R1.1), U1101.10 (a)
Stage05_SEG_B: RN1101.2 (R2.1), U1101.12 (b)
Stage05_SEG_C: RN1101.3 (R3.1), U1101.13 (c)
Stage05_SEG_D: RN1101.4 (R4.1), U1101.9 (d)
Stage05_SEG_E: RN1101.5 (R5.1), U1101.11 (e)
Stage05_SEG_F: RN1101.6 (R6.1), U1101.6 (f)
Stage05_SEG_G: RN1101.7 (R7.1), U1101.7 (g)

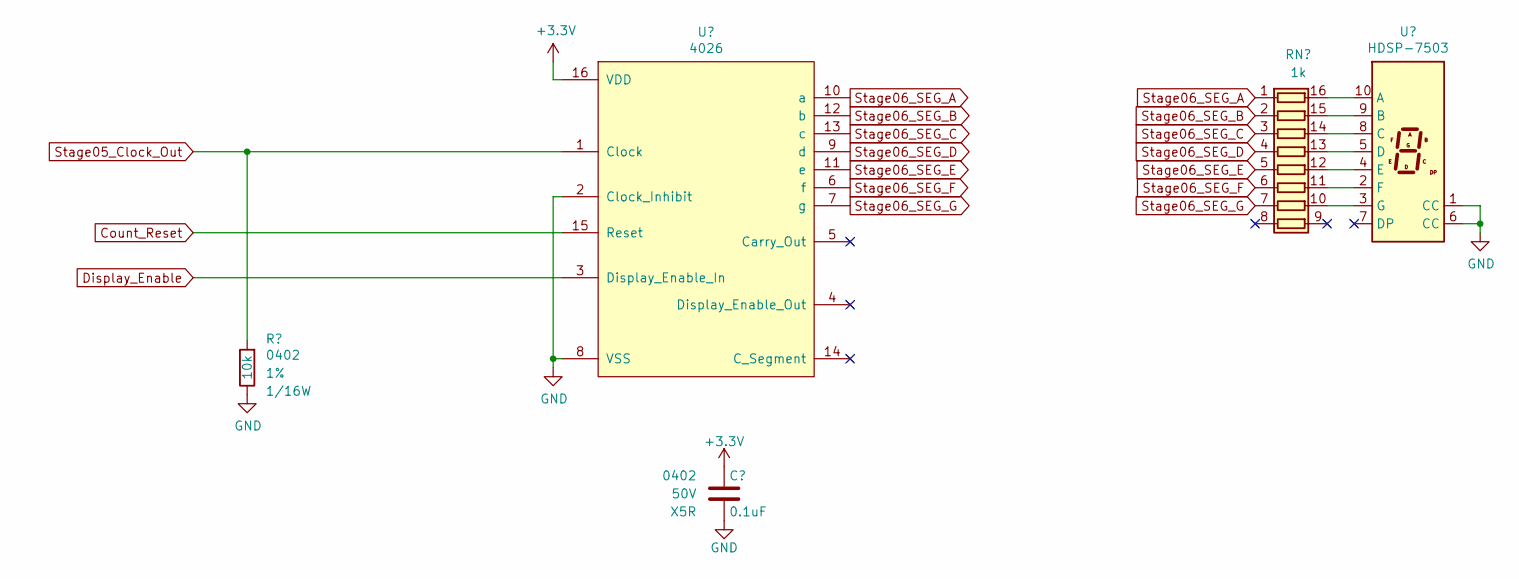
[picture p22: schematic Stage_06.kicad_sch, Stopwatch]

Parts:
C1201: 0.1uF; C_0402; Voltage 50V; Digi-Key PN 490-10697-1-ND
R1201: 10k; R_0402; Tolerance 1%; Digi-Key PN RMCF0402FT10K0CT-ND
RN1201: 1k; R_Cat16-8; Digi-Key PN CAT16-102J8LFCT-ND
U1201: 4026; TSSOP-16_4.4x5mm_Pitch0.65mm; Digi-Key PN 296-32878-5-ND
U1202: HDSP-7503; HDSP-A151; Digi-Key PN 516-1203-5-ND

Connections:
+3.3V: C1201.1, U1201.16 (VDD); also elsewhere on the board
Count_Reset: U1201.15 (Reset); also elsewhere on the board
Display_Enable: U1201.3 (Display_Enable_In); also elsewhere on the board
GND: C1201.2, R1201.2, U1201.2 (Clock_Inhibit), U1201.8 (VSS), U1202.1 (CC), U1202.6 (CC); also elsewhere on the board
unnamed: RN1201.16 (R1.2), U1202.10 (A)
unnamed: RN1201.15 (R2.2), U1202.9 (B)
unnamed: RN1201.14 (R3.2), U1202.8 (C)
unnamed: RN1201.13 (R4.2), U1202.5 (D)
unnamed: RN1201.12 (R5.2), U1202.4 (E)
unnamed: RN1201.11 (R6.2), U1202.2 (F)
unnamed: RN1201.10 (R7.2), U1202.3 (G)
Stage05_Clock_Out: R1201.1, U1201.1 (Clock); also elsewhere on the board
Stage06_SEG_A: RN1201.1 (R1.1), U1201.10 (a)
Stage06_SEG_B: RN1201.2 (R2.1), U1201.12 (b)
Stage06_SEG_C: RN1201.3 (R3.1), U1201.13 (c)
Stage06_SEG_D: RN1201.4 (R4.1), U1201.9 (d)
Stage06_SEG_E: RN1201.5 (R5.1), U1201.11 (e)
Stage06_SEG_F: RN1201.6 (R6.1), U1201.6 (f)
Stage06_SEG_G: RN1201.7 (R7.1), U1201.7 (g)

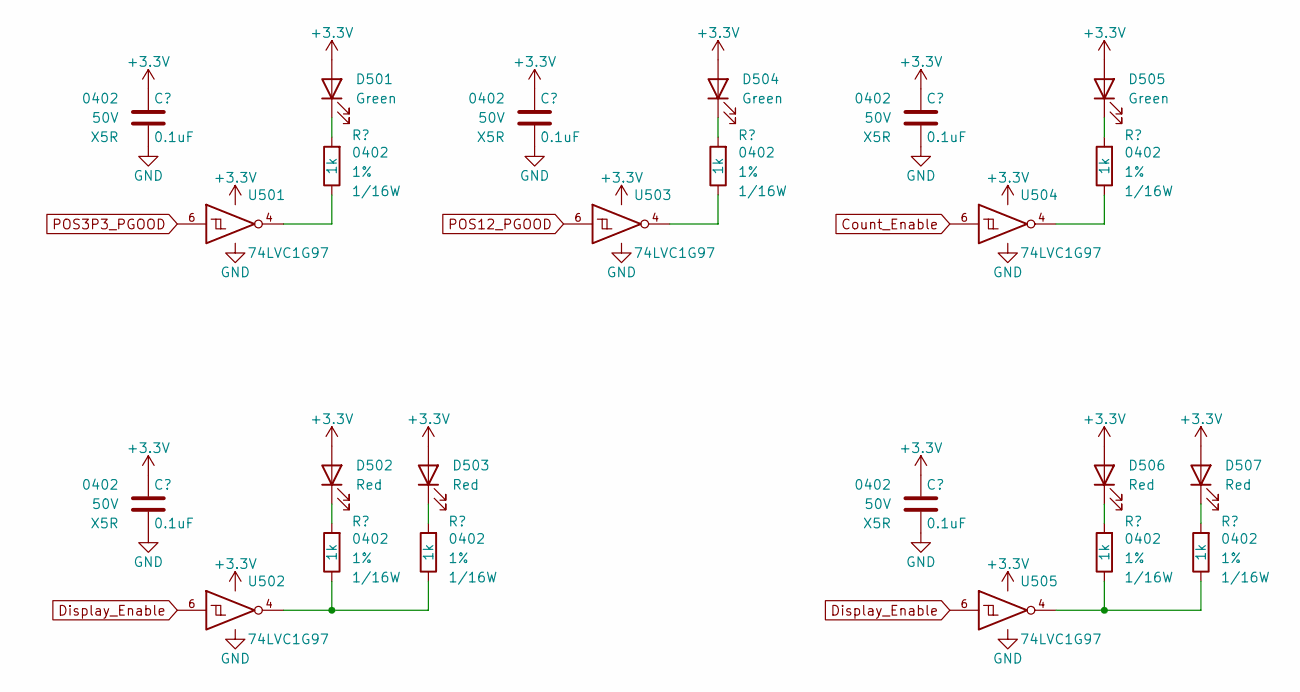
[picture p23: schematic Status_LEDs.kicad_sch, Stopwatch]

Parts:
C501, C502, C503, C504, C505: 0.1uF; C_0402; Voltage 50V; Digi-Key PN 490-10697-1-ND
D501, D504, D505: Green; LED_0402; Digi-Key PN 754-1101-1-ND
D502, D503, D506, D507: Red; LED_0402; Digi-Key PN 754-1104-1-ND
R501, R502, R503, R504, R505, R506, R507: 1k; R_0402; Tolerance 1%; Digi-Key PN RMCF0402FT1K00CT-ND
U501, U502, U503, U504, U505: 74LVC1G97; Fairchild_MicroPak2-6_1.0x1.0mm_P0.35mm; Digi-Key PN 296-29875-1-ND

Connections:
+3.3V: C501.1, C502.1, C503.1, C504.1, C505.1, D501.2 (A), D502.2 (A), D503.2 (A), D504.2 (A), D505.2 (A), D506.2 (A), D507.2 (A), U501.1 (VCC), U501.5 (VCC), U502.1 (VCC), U502.5 (VCC), U503.1 (VCC), U503.5 (VCC), U504.1 (VCC), U504.5 (VCC), U505.1 (VCC), U505.5 (VCC); also elsewhere on the board
Count_Enable: U504.6; also elsewhere on the board
Display_Enable: U502.6, U505.6; also elsewhere on the board
GND: C501.2, C502.2, C503.2, C504.2, C505.2, U501.2 (GND), U501.3 (GND), U502.2 (GND), U502.3 (GND), U503.2 (GND), U503.3 (GND), U504.2 (GND), U504.3 (GND), U505.2 (GND), U505.3 (GND); also elsewhere on the board
unnamed: D501.1 (K), R501.1
unnamed: D502.1 (K), R502.1
unnamed: D503.1 (K), R503.1
unnamed: D504.1 (K), R504.1
unnamed: D505.1 (K), R505.1
unnamed: D506.1 (K), R506.1
unnamed: D507.1 (K), R507.1
unnamed: R501.2, U501.4
unnamed: R502.2, R503.2, U502.4
unnamed: R504.2, U503.4
unnamed: R505.2, U504.4
unnamed: R506.2, R507.2, U505.4
POS3P3_PGOOD: U501.6; also elsewhere on the board
POS12_PGOOD: U503.6; also elsewhere on the board

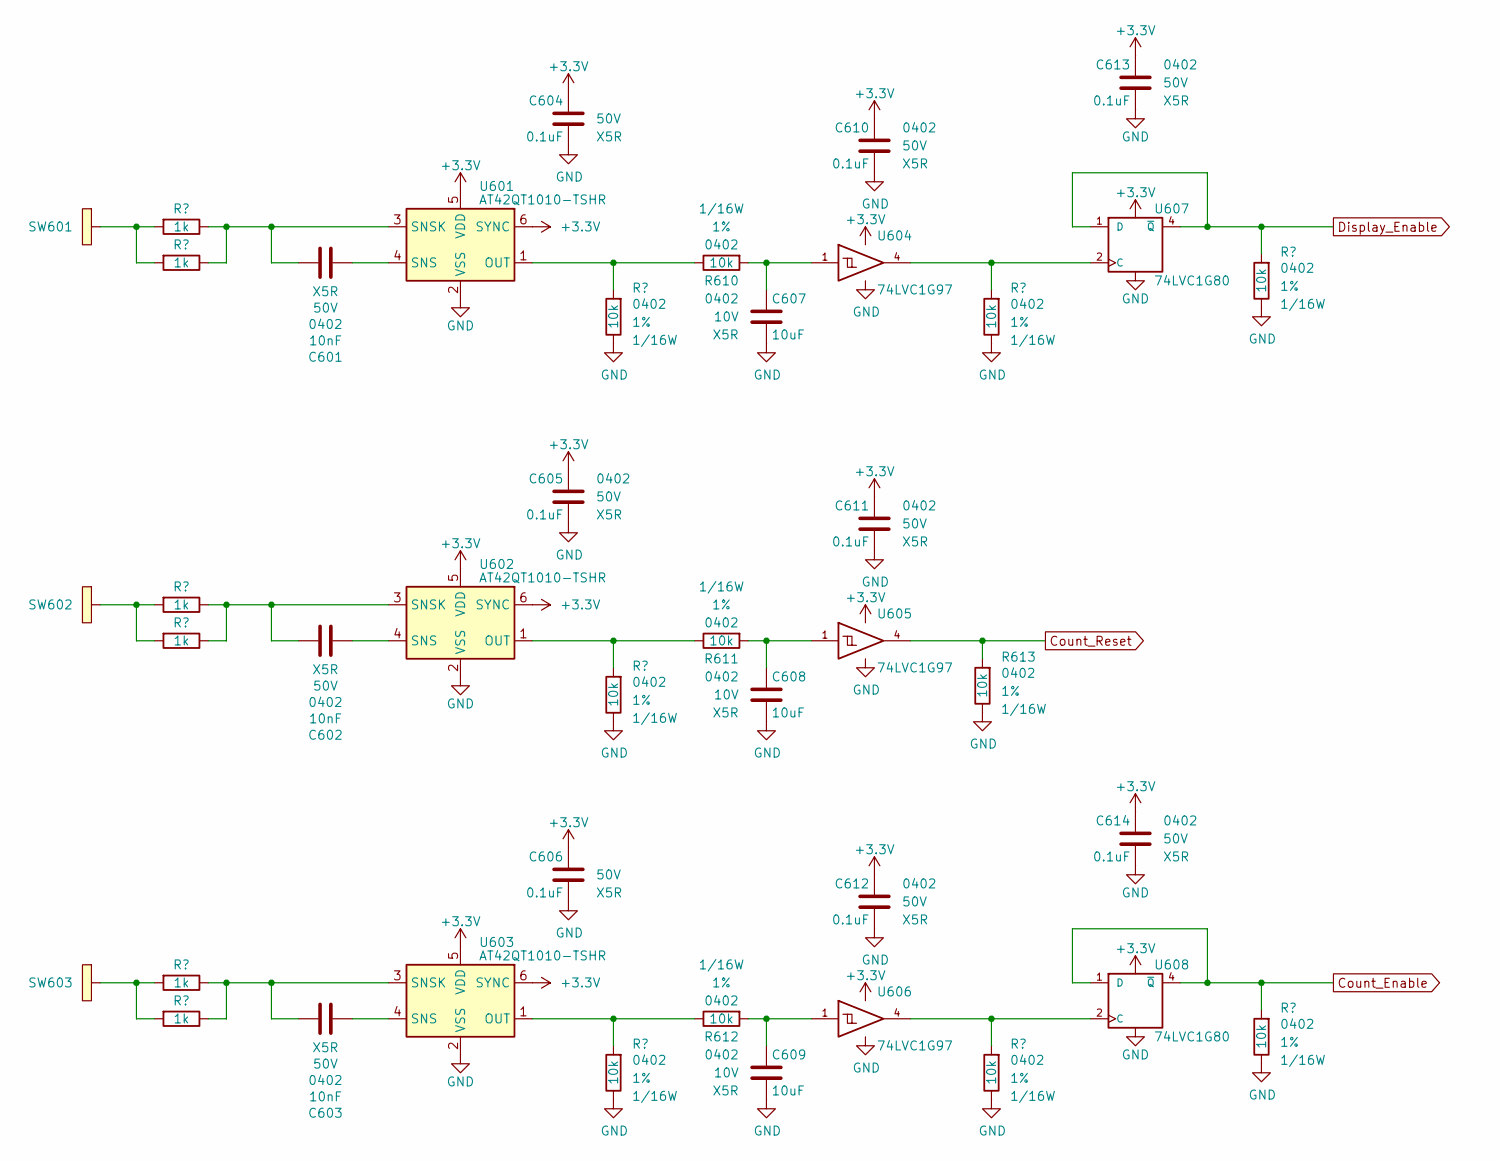
[picture p24: schematic Pushbuttons.kicad_sch, Stopwatch]

Parts:
C601, C602, C603: 10nF; C_0402; Voltage 50V; Digi-Key PN 445-12201-1-ND
C604, C605, C606, C610, C611, C612, C613, C614: 0.1uF; C_0402; Voltage 50V; Digi-Key PN 490-10697-1-ND
C607, C608, C609: 10uF; C_0402; Voltage 10V; Digi-Key PN 490-GRM155R61A106ME11DCT-ND
R601, R602, R603, R604, R605, R606: 1k; R_0402; Tolerance 1%; Digi-Key PN RMCF0402FT1K00CT-ND
R607, R608, R609, R610, R611, R612, R613, R614, R615, R616, R617: 10k; R_0402; Tolerance 1%; Digi-Key PN RMCF0402FT10K0CT-ND
SW601, SW602, SW603: Cap_Touch; Capacitive_Touch_Pad
U601, U602, U603: AT42QT1010-TSHR; SOT-23-6; Digi-Key PN AT42QT1010-TSHRCT-ND
U604, U605, U606: 74LVC1G97; Fairchild_MicroPak2-6_1.0x1.0mm_P0.35mm; Digi-Key PN 296-29875-1-ND
U607, U608: 74LVC1G80; Texas_X2SON-5_0.8x0.8mm_P0.48mm; Digi-Key PN 1727-74LVC1G80GX,125CT-ND

Connections:
+3.3V: C604.1, C605.1, C606.1, C610.1, C611.1, C612.1, C613.1, C614.1, U601.5 (VDD), U601.6 (SYNC), U602.5 (VDD), U602.6 (SYNC), U603.5 (VDD), U603.6 (SYNC), U604.5 (VCC), U605.5 (VCC), U606.5 (VCC), U607.5 (VCC), U608.5 (VCC); also elsewhere on the board
Count_Enable: R617.1, U608.1 (D), U608.4 (~Q); also elsewhere on the board
Count_Reset: R613.1, U605.4; also elsewhere on the board
Display_Enable: R616.1, U607.1 (D), U607.4 (~Q); also elsewhere on the board
GND: C604.2, C605.2, C606.2, C607.2, C608.2, C609.2, C610.2, C611.2, C612.2, C613.2, C614.2, R607.2, R608.2, R609.2, R613.2, R614.2, R615.2, R616.2, R617.2, U601.2 (VSS), U602.2 (VSS), U603.2 (VSS), U604.2 (GND), U604.3 (GND), U604.6 (GND), U605.2 (GND), U605.3 (GND), U605.6 (GND), U606.2 (GND), U606.3 (GND), U606.6 (GND), U607.3 (GND), U608.3 (GND); also elsewhere on the board
unnamed: C607.1, R610.1, U604.1
unnamed: C608.1, R611.1, U605.1
unnamed: C609.1, R612.1, U606.1
unnamed: R601.1, R602.1, SW601.1 (TP)
unnamed: R603.1, R604.1, SW602.1 (TP)
unnamed: R605.1, R606.1, SW603.1 (TP)
unnamed: R607.1, R610.2, U601.1 (OUT)
unnamed: C601.1, U601.4 (SNS)
unnamed: C601.2, R601.2, R602.2, U601.3 (SNSK)
unnamed: R608.1, R611.2, U602.1 (OUT)
unnamed: C602.1, U602.4 (SNS)
unnamed: C602.2, R603.2, R604.2, U602.3 (SNSK)
unnamed: R609.1, R612.2, U603.1 (OUT)
unnamed: C603.1, U603.4 (SNS)
unnamed: C603.2, R605.2, R606.2, U603.3 (SNSK)
unnamed: R614.1, U604.4, U607.2 (C)
unnamed: R615.1, U606.4, U608.2 (C)

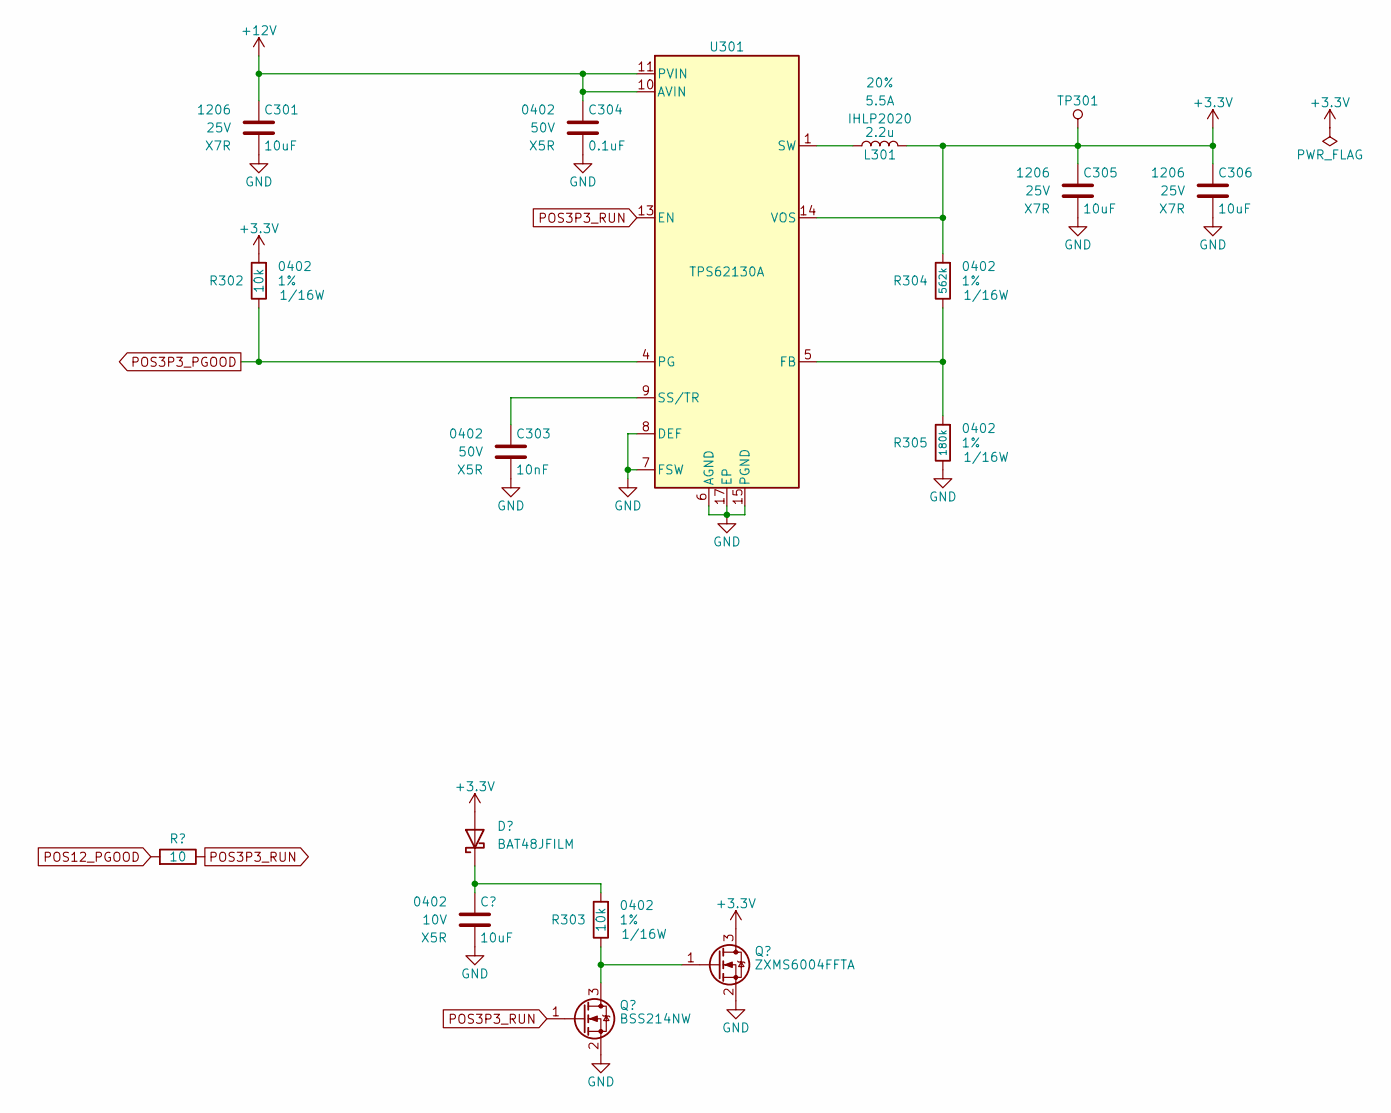
[picture p25: schematic POS3P3_Power_Supply.kicad_sch, Stopwatch]

Parts:
C301, C305, C306: 10uF; C_1206; Voltage 25V; Digi-Key PN 1276-7031-1-ND
C302: 10uF; C_0402; Voltage 10V; Digi-Key PN 490-GRM155R61A106ME11DCT-ND
C303: 10nF; C_0402; Voltage 50V; Digi-Key PN 445-12201-1-ND
C304: 0.1uF; C_0402; Voltage 50V; Digi-Key PN 490-10697-1-ND
D301: BAT48JFILM; D_SOD-323; Digi-Key PN 497-5711-1-ND
L301: 2.2u; L_Vishay_IHLP-2020; Tolerance 20%; Digi-Key PN 541-1236-1-ND
Q301: BSS214NW; SOT-323_SC-70; Digi-Key PN BSS214NWH6327XTSA1CT-ND
Q302: ZXMS6004FFTA; SOT-23; Digi-Key PN ZXMS6004FFCT-ND
R301: 10; R_0402; Tolerance 1%; Digi-Key PN RMCF0402FT10R0CT-ND
R302, R303: 10k; R_0402; Tolerance 1%; Digi-Key PN RMCF0402FT10K0CT-ND
R304: 562k; R_0402; Tolerance 1%; Digi-Key PN RMCF0402FT562KCT-ND
R305: 180k; R_0402; Tolerance 1%; Digi-Key PN RMCF0402FT180KCT-ND
TP301: TP; Test_Point
U301: TPS62130A; QFN-16-1EP_3x3mm_Pitch0.5mm; Digi-Key PN 296-39446-1-ND

Connections:
+3.3V: C305.1, C306.1, D301.2 (A), L301.2, Q302.3 (D), R302.1, R304.1, TP301.1 (TP), U301.14 (VOS); also elsewhere on the board
+12V: C301.1, C304.1, U301.10 (AVIN), U301.11 (PVIN), U301.12 (PVIN); also elsewhere on the board
GND: C301.2, C302.2, C303.2, C304.2, C305.2, C306.2, Q301.2 (S), Q302.2 (S), R305.2, U301.6 (AGND), U301.7 (FSW), U301.8 (DEF), U301.15 (PGND), U301.16 (PGND), U301.17 (EP); also elsewhere on the board
unnamed: C302.1, D301.1 (K), R303.1
unnamed: L301.1, U301.1 (SW), U301.2 (SW), U301.3 (SW)
unnamed: Q301.3 (D), Q302.1 (G), R303.2
unnamed: R304.2, R305.1, U301.5 (FB)
unnamed: C303.1, U301.9 (SS/TR)
POS3P3_PGOOD: R302.2, U301.4 (PG); also elsewhere on the board
POS3P3_RUN: Q301.1 (G), R301.2, U301.13 (EN)
POS12_PGOOD: R301.1; also elsewhere on the board

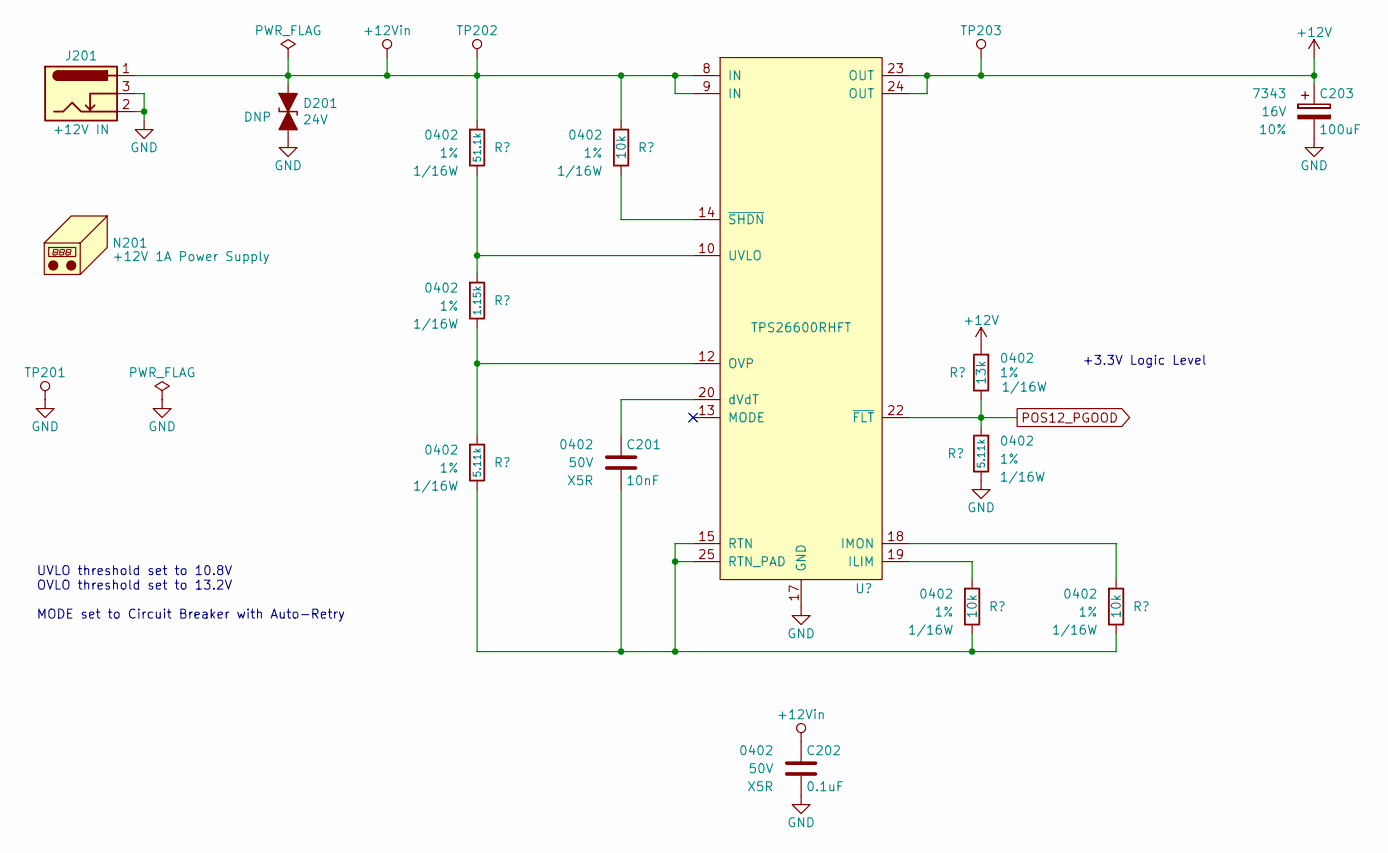
[picture p26: schematic POS12_Power_Input.kicad_sch, Stopwatch]

Parts:
C201: 10nF; C_0402; Voltage 50V; Digi-Key PN 445-12201-1-ND
C202: 0.1uF; C_0402; Voltage 50V; Digi-Key PN 490-10697-1-ND
C203: 100uF; CP_EIA-7343-43_Kemet-X; Voltage 16V; Tolerance 10%; Digi-Key PN 718-1102-1-ND
D201: 24V; D_SMA; Digi-Key PN SMAJ24CALFCT-ND
J201: +12V IN; BARREL_JACK; Digi-Key PN CP-202BH-ND
N201: +12V 1A Power Supply; Digi-Key PN 993-1335-ND
R201: 51.1k; R_0402; Tolerance 1%; Digi-Key PN RMCF0402FT51K1CT-ND
R202: 1.15k; R_0402; Tolerance 1%; Digi-Key PN RMCF0402FT1K15CT-ND
R203, R207: 5.11k; R_0402; Tolerance 1%; Digi-Key PN RMCF0402FT5K11CT-ND
R204, R205, R208: 10k; R_0402; Tolerance 1%; Digi-Key PN RMCF0402FT10K0CT-ND
R206: 13k; R_0402; Tolerance 1%; Digi-Key PN RMCF0402FT13K0CT-ND
TP201: TP; PinHeader_1x01_P2.54mm_Horizontal
TP202, TP203: TP_Pad; Test_Point
U201: TPS26600RHFT; QFN-24-1EP_4x5mm_Pitch0.5mm; Digi-Key PN 296-45478-1-ND

Connections:
+12V: C203.1, R206.1, TP203.1 (TP), U201.23 (OUT), U201.24 (OUT); also elsewhere on the board
+12Vin: C202.1, D201.1 (A1), J201.1, R201.1, R204.1, TP202.1 (TP), U201.8 (IN), U201.9 (IN)
GND: C202.2, C203.2, D201.2 (A2), J201.2, J201.3, R207.2, TP201.1 (TP), U201.17 (GND); also elsewhere on the board
unnamed: R205.1, U201.19 (ILIM)
unnamed: R208.1, U201.18 (IMON)
unnamed: R202.2, R203.1, U201.12 (OVP)
unnamed: C201.2, R203.2, R205.2, R208.2, U201.15 (RTN), U201.25 (RTN_PAD)
unnamed: R201.2, R202.1, U201.10 (UVLO)
unnamed: C201.1, U201.20 (dVdT)
unnamed: R204.2, U201.14 (~SHDN)
POS12_PGOOD: R206.2, R207.1, U201.22 (~FLT); also elsewhere on the board

Notes on the sheet:
+3.3V Logic Level
UVLO threshold set to 10.8V OVLO threshold set to 13.2V MODE set to Circuit Breaker with Auto-Retry

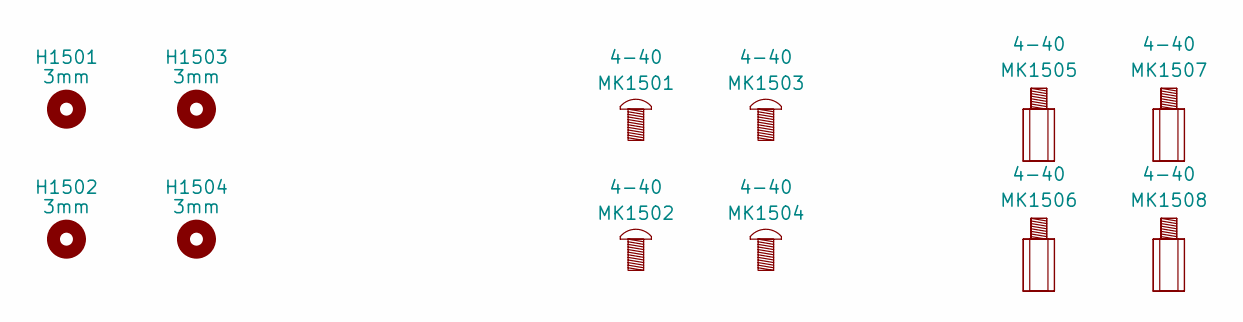
[picture p27: schematic Mechanical.kicad_sch, Stopwatch]

Parts:
H1501, H1502, H1503, H1504: 3mm; MountingHole_3mm
MK1501, MK1502, MK1503, MK1504: 4-40; Digi-Key PN 36-9900-ND
MK1505, MK1506, MK1507, MK1508: 4-40; Digi-Key PN 36-1892-ND
