drewsum/Stopwatch/hdw/rev_a/Stopwatch/Stopwatch.kicad_pcb

## KiCad design hdw/rev_a/Stopwatch/Stopwatch.kicad_pcb (continued)

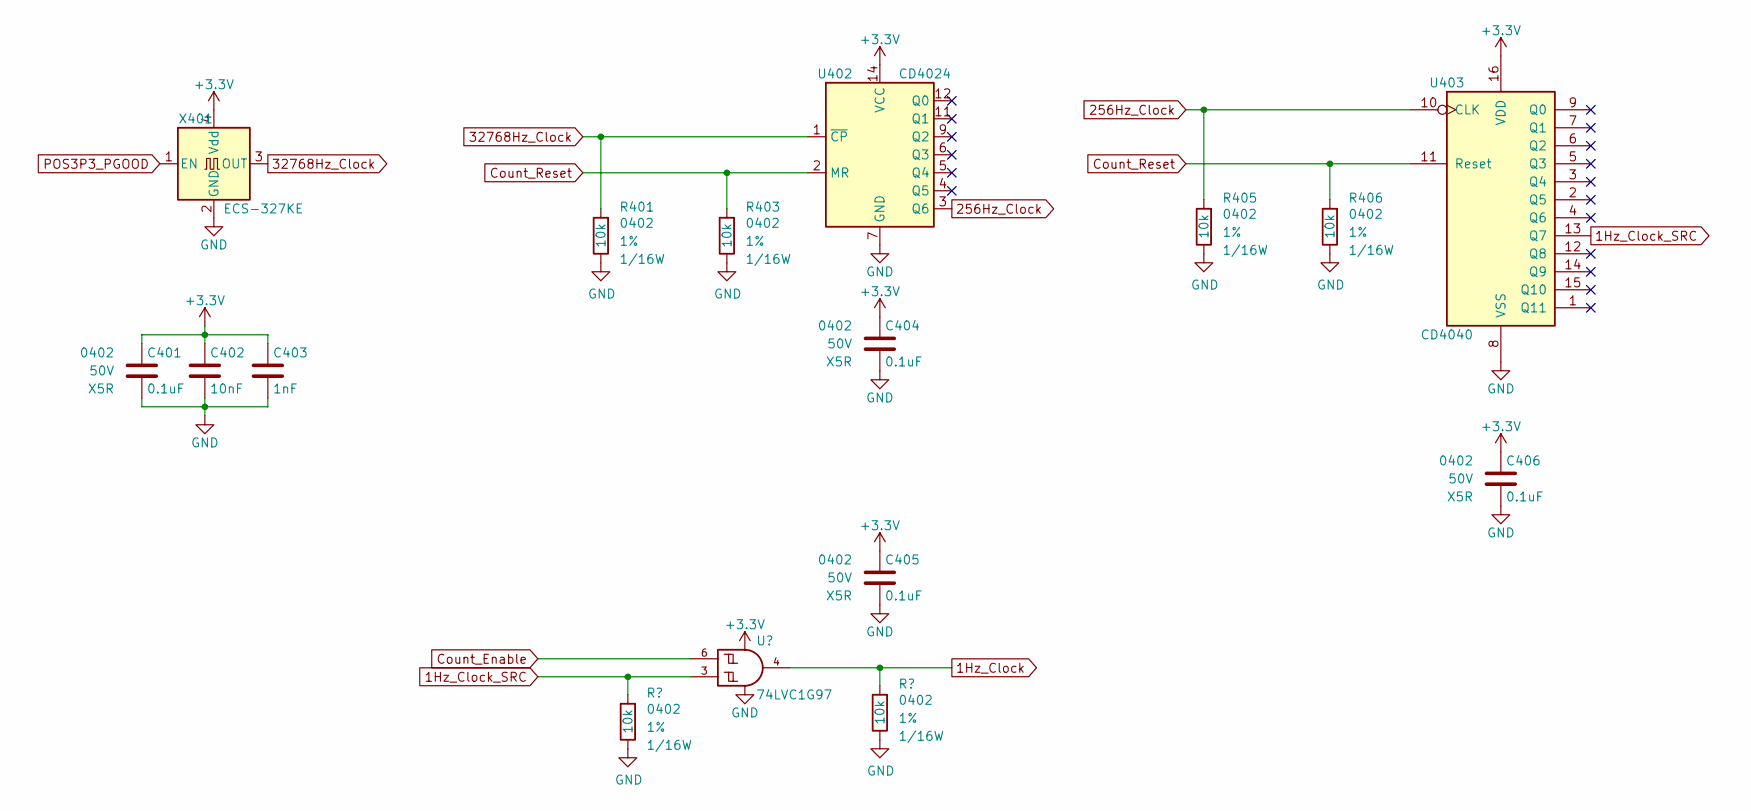
[picture p28: schematic Oscillator.kicad_sch, Stopwatch]

Parts:
C401, C404, C405, C406: 0.1uF; C_0402; Voltage 50V; Digi-Key PN 490-10697-1-ND
C402: 10nF; C_0402; Voltage 50V; Digi-Key PN 445-12201-1-ND
C403: 1nF; C_0402; Voltage 50V; Digi-Key PN 445-7376-1-ND
R401, R402, R403, R404, R405, R406: 10k; R_0402; Tolerance 1%; Digi-Key PN RMCF0402FT10K0CT-ND
U401: 74LVC1G97; Fairchild_MicroPak2-6_1.0x1.0mm_P0.35mm; Digi-Key PN 296-29875-1-ND
U402: CD4024; TSSOP-14_4.4x5mm_Pitch0.65mm; Digi-Key PN 296-49578-ND
U403: CD4040; DHVQFN16-1ep_3p5x2p5mm; Digi-Key PN 1727-7992-1-ND
X401: ECS-327KE; Oscillator_SMD_Abracon_ASE-4Pin_3.2x2.5mm; Digi-Key PN XC1751CT-ND

Connections:
1Hz_Clock: R404.1, U401.4; also elsewhere on the board
1Hz_Clock_SRC: R402.1, U401.3, U403.13 (Q7)
256Hz_Clock: R405.1, U402.3 (Q6), U403.10 (CLK)
32768Hz_Clock: R401.1, U402.1 (~CP), X401.3 (OUT)
+3.3V: C401.1, C402.1, C403.1, C404.1, C405.1, C406.1, U401.5 (VCC), U402.14 (VCC), U403.16 (VDD), X401.4 (Vdd); also elsewhere on the board
Count_Enable: U401.6; also elsewhere on the board
Count_Reset: R403.1, R406.1, U402.2 (MR), U403.11 (Reset); also elsewhere on the board
GND: C401.2, C402.2, C403.2, C404.2, C405.2, C406.2, R401.2, R402.2, R403.2, R404.2, R405.2, R406.2, U401.1 (GND), U401.2 (GND), U402.7 (GND), U403.8 (VSS), U403.17, X401.2 (GND); also elsewhere on the board
POS3P3_PGOOD: X401.1 (EN); also elsewhere on the board

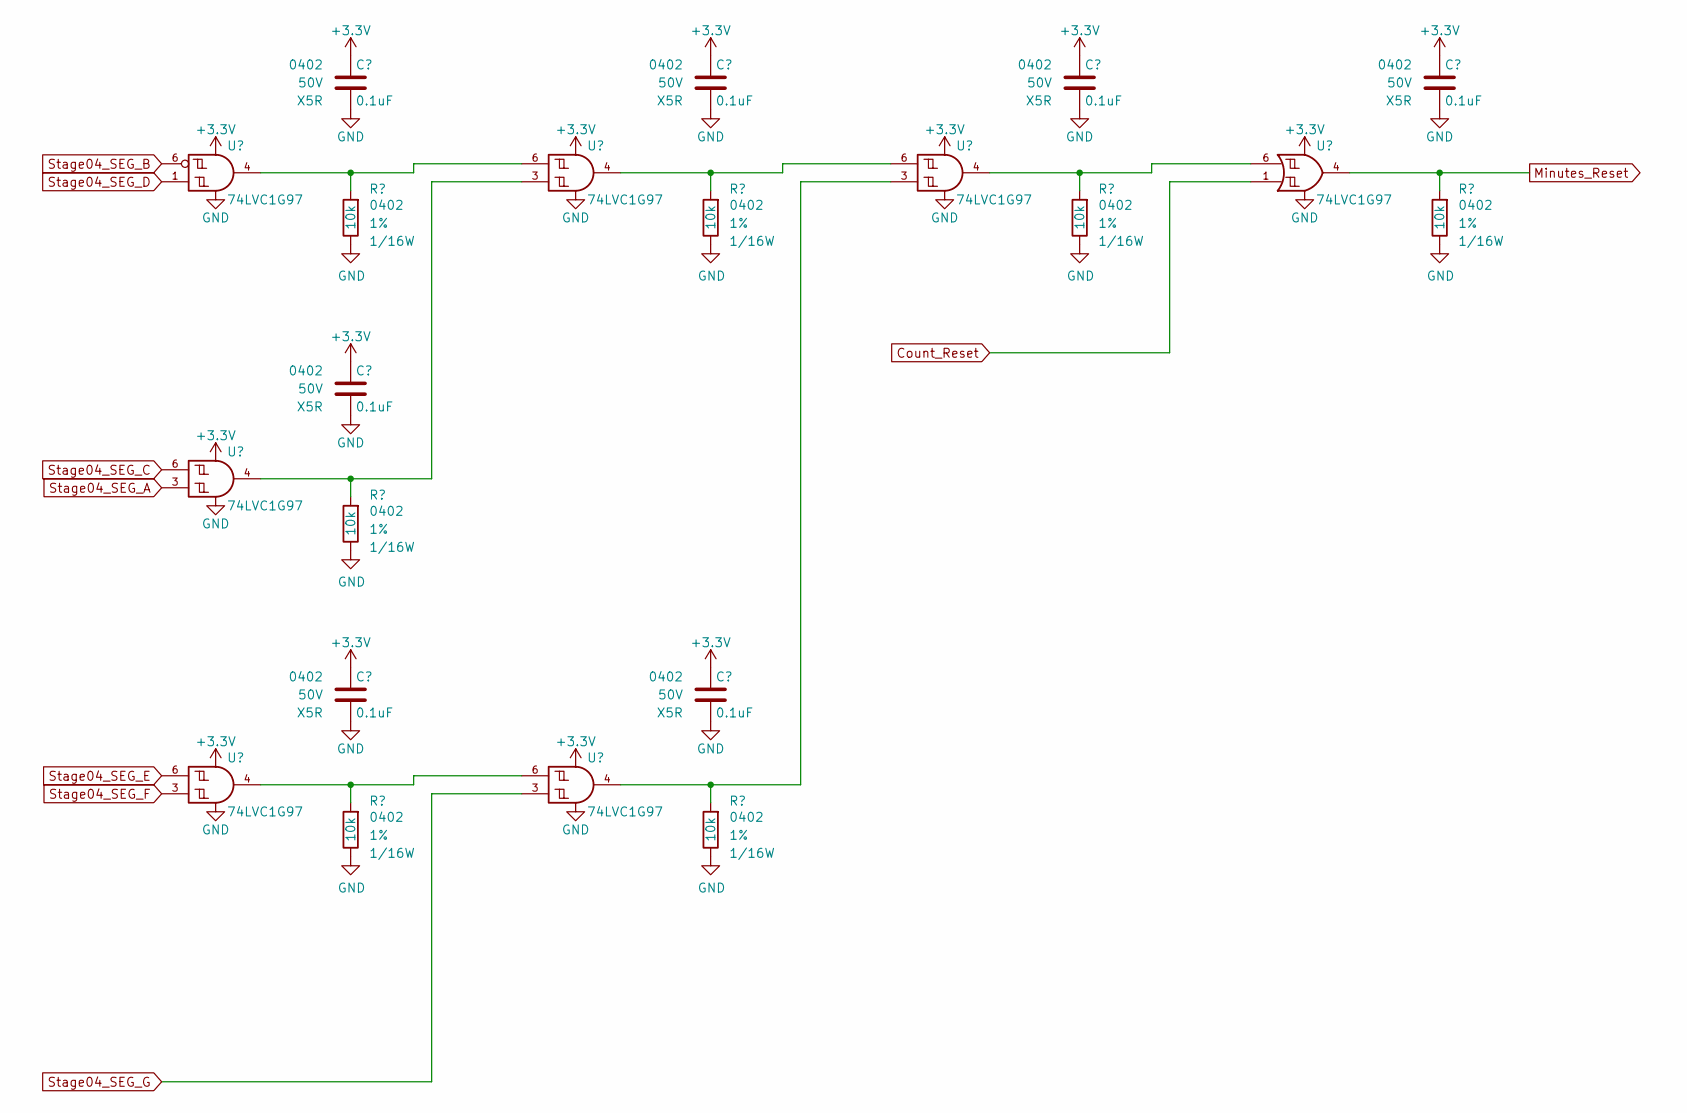
[picture p29: schematic minutes_reset.kicad_sch, Stopwatch]

Parts:
C1401, C1402, C1403, C1404, C1405, C1406, C1407: 0.1uF; C_0402; Voltage 50V; Digi-Key PN 490-10697-1-ND
R1401, R1402, R1403, R1404, R1405, R1406, R1407: 10k; R_0402; Tolerance 1%; Digi-Key PN RMCF0402FT10K0CT-ND
U1401, U1402, U1403, U1404, U1405, U1406, U1407: 74LVC1G97; Fairchild_MicroPak2-6_1.0x1.0mm_P0.35mm; Digi-Key PN 296-29875-1-ND

Connections:
+3.3V: C1401.1, C1402.1, C1403.1, C1404.1, C1405.1, C1406.1, C1407.1, U1401.5 (VCC), U1402.5 (VCC), U1403.5 (VCC), U1404.5 (VCC), U1405.5 (VCC), U1406.5 (VCC), U1407.3 (VCC), U1407.5 (VCC); also elsewhere on the board
Count_Reset: U1407.1; also elsewhere on the board
GND: C1401.2, C1402.2, C1403.2, C1404.2, C1405.2, C1406.2, C1407.2, R1401.2, R1402.2, R1403.2, R1404.2, R1405.2, R1406.2, R1407.2, U1401.2 (GND), U1401.3 (GND), U1402.1 (GND), U1402.2 (GND), U1403.1 (GND), U1403.2 (GND), U1404.1 (GND), U1404.2 (GND), U1405.1 (GND), U1405.2 (GND), U1406.1 (GND), U1406.2 (GND), U1407.2 (GND); also elsewhere on the board
Minutes_Reset: R1407.1, U1407.4; also elsewhere on the board
unnamed: R1401.1, U1401.4, U1404.6
unnamed: R1402.1, U1402.4, U1404.3
unnamed: R1403.1, U1403.4, U1405.6
unnamed: R1404.1, U1404.4, U1406.6
unnamed: R1405.1, U1405.4, U1406.3
unnamed: R1406.1, U1406.4, U1407.6
Stage04_SEG_A: U1402.3; also elsewhere on the board
Stage04_SEG_B: U1401.6; also elsewhere on the board
Stage04_SEG_C: U1402.6; also elsewhere on the board
Stage04_SEG_D: U1401.1; also elsewhere on the board
Stage04_SEG_E: U1403.6; also elsewhere on the board
Stage04_SEG_F: U1403.3; also elsewhere on the board
Stage04_SEG_G: U1405.3; also elsewhere on the board

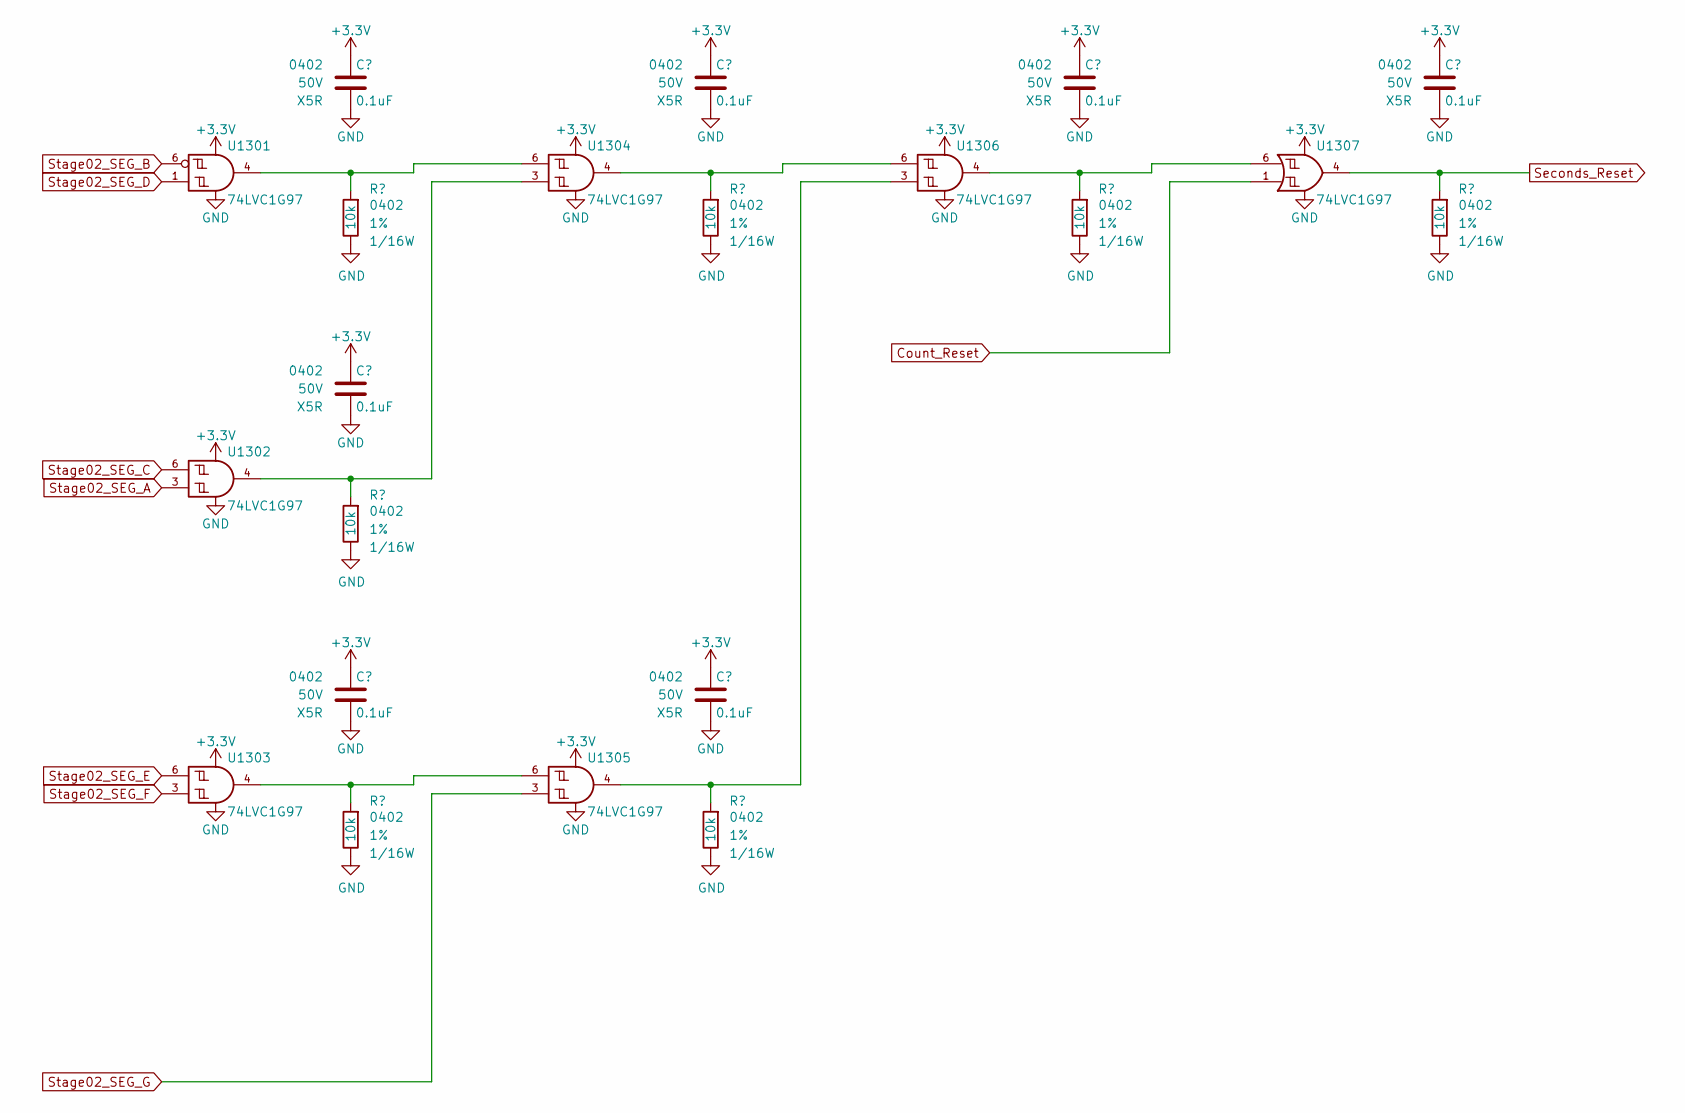
[picture p30: schematic seconds_reset.kicad_sch, Stopwatch]

Parts:
C1301, C1302, C1303, C1304, C1305, C1306, C1307: 0.1uF; C_0402; Voltage 50V; Digi-Key PN 490-10697-1-ND
R1301, R1302, R1303, R1304, R1305, R1306, R1307: 10k; R_0402; Tolerance 1%; Digi-Key PN RMCF0402FT10K0CT-ND
U1301, U1302, U1303, U1304, U1305, U1306, U1307: 74LVC1G97; Fairchild_MicroPak2-6_1.0x1.0mm_P0.35mm; Digi-Key PN 296-29875-1-ND

Connections:
+3.3V: C1301.1, C1302.1, C1303.1, C1304.1, C1305.1, C1306.1, C1307.1, U1301.5 (VCC), U1302.5 (VCC), U1303.5 (VCC), U1304.5 (VCC), U1305.5 (VCC), U1306.5 (VCC), U1307.3 (VCC), U1307.5 (VCC); also elsewhere on the board
Count_Reset: U1307.1; also elsewhere on the board
GND: C1301.2, C1302.2, C1303.2, C1304.2, C1305.2, C1306.2, C1307.2, R1301.2, R1302.2, R1303.2, R1304.2, R1305.2, R1306.2, R1307.2, U1301.2 (GND), U1301.3 (GND), U1302.1 (GND), U1302.2 (GND), U1303.1 (GND), U1303.2 (GND), U1304.1 (GND), U1304.2 (GND), U1305.1 (GND), U1305.2 (GND), U1306.1 (GND), U1306.2 (GND), U1307.2 (GND); also elsewhere on the board
unnamed: R1301.1, U1301.4, U1304.6
unnamed: R1302.1, U1302.4, U1304.3
unnamed: R1303.1, U1303.4, U1305.6
unnamed: R1304.1, U1304.4, U1306.6
unnamed: R1305.1, U1305.4, U1306.3
unnamed: R1306.1, U1306.4, U1307.6
Seconds_Reset: R1307.1, U1307.4; also elsewhere on the board
Stage02_SEG_A: U1302.3; also elsewhere on the board
Stage02_SEG_B: U1301.6; also elsewhere on the board
Stage02_SEG_C: U1302.6; also elsewhere on the board
Stage02_SEG_D: U1301.1; also elsewhere on the board
Stage02_SEG_E: U1303.6; also elsewhere on the board
Stage02_SEG_F: U1303.3; also elsewhere on the board
Stage02_SEG_G: U1305.3; also elsewhere on the board

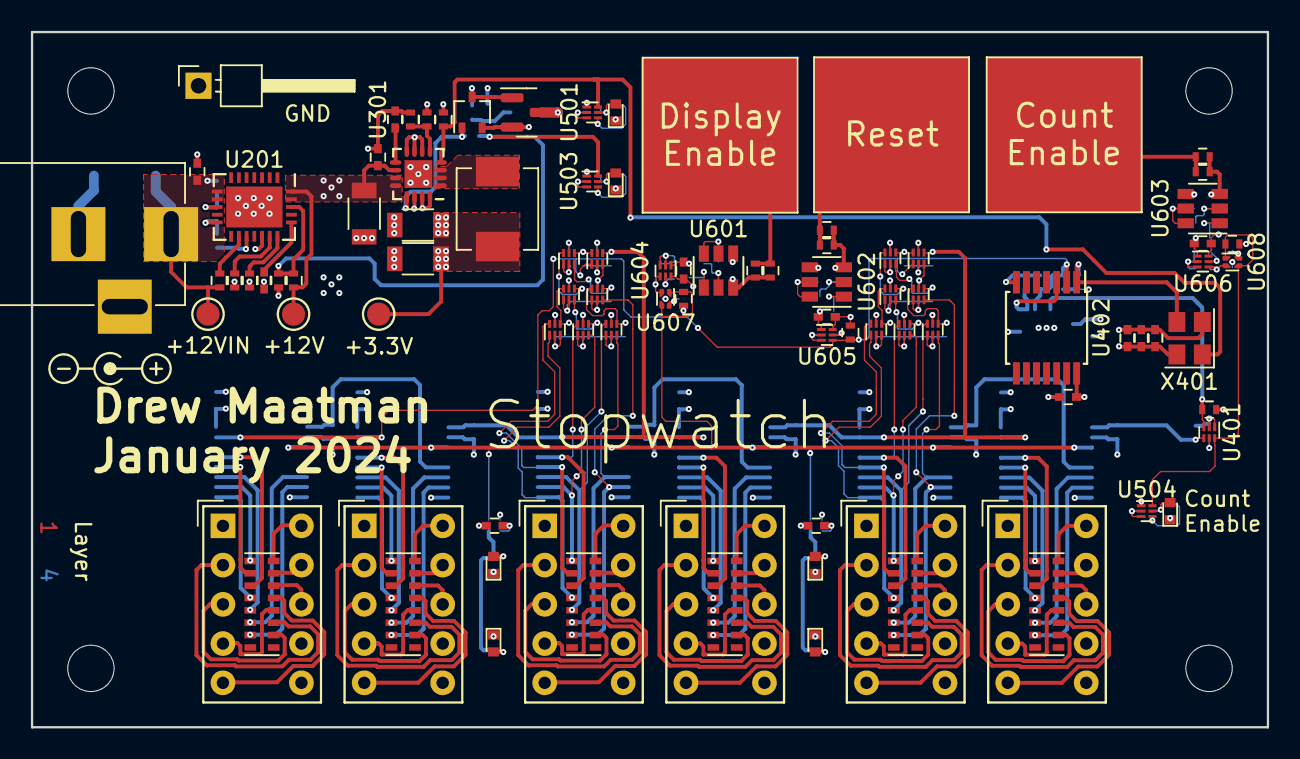
[picture p31: board Stopwatch.kicad_pcb from above]

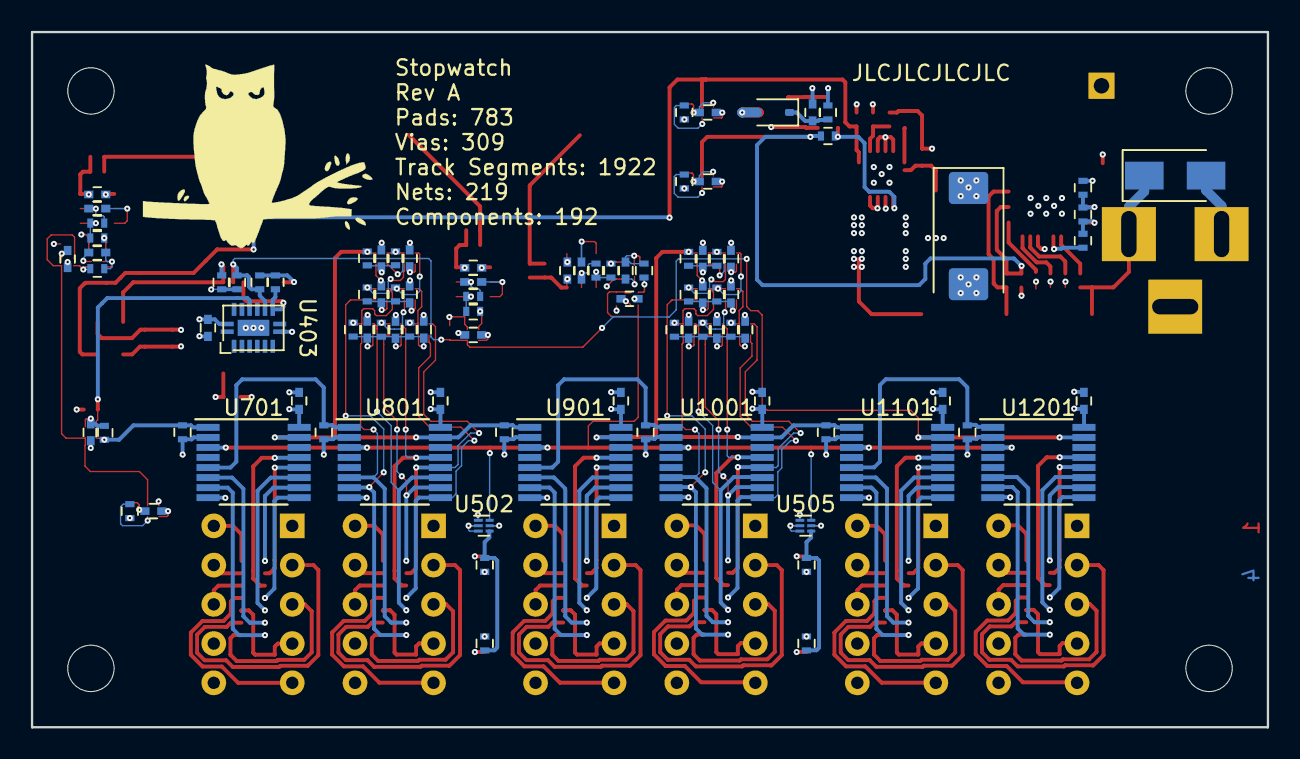
[picture p32: board Stopwatch.kicad_pcb from below]

Board: 4 copper layers, 80.0 x 45.0 mm, 192 parts (94 on the bottom side), 156 nets.
