drewsum/Stopwatch/(commit log)

2019-09-01 Added kicad project, started schematic
    [Incrementor.kicad_pcb, Incrementor.sch, Stage_01.sch]
2019-09-01 Added duplicate stage pages, oscillator
    [Oscillator.sch, Stage_02.sch, Stage_03.sch, Stage_04.sch, Stage_05.sch, Stage_06.sch, Stage_07.sch, Stage_08.sch]
2019-09-01 Added a lot more schematic cheets
    [Clock_Output.sch, Clock_Selection.sch, External_Clock.sch, Incrementor.sch, Mechanical.sch, Oscillator.sch, POS12_Power_Input.sch, POS3P3_Power_Supply.sch]
2019-09-04 Added more schematic sheets
    [Clock_Output.sch, Clock_Selection.sch, External_Clock.sch, Incrementor.sch, Mechanical.sch, Oscillator.sch, POS12_Power_Input.sch, POS3P3_Power_Supply.sch]
2019-09-05 fixing branch
    [Mechanical.sch, Status_LEDs.sch]
2019-09-07 Reordered schematic sheets
    [Clock_Output.sch, Clock_Selection.sch, External_Clock.sch, Incrementor.sch, Mechanical.sch, Oscillator.sch, POS12_Power_Input.sch, POS3P3_Power_Supply.sch]
2019-09-07 Assigned REFDESs
    [Clock_Output.sch, Clock_Selection.sch, External_Clock.sch, Oscillator.sch, POS12_Power_Input.sch, POS3P3_Power_Supply.sch, Pushbuttons.sch, Stage_01.sch]
2019-09-07 Assigned Digi Key PNs and footprints
    [Clock_Output.sch, Clock_Selection.sch, External_Clock.sch, Oscillator.sch, POS12_Power_Input.sch, POS3P3_Power_Supply.sch, Pushbuttons.sch, Stage_01.sch]
2019-09-07 Fixed library references, completed ERC
    [Clock_Output.sch, Clock_Selection.sch, External_Clock.sch, Oscillator.sch, POS3P3_Power_Supply.sch, Pushbuttons.sch, Stage_01.sch, Stage_02.sch]
2019-09-24 Migrated to kicad 5 footprint libs, pulled changes into PCB
    [Incrementor.kicad_pcb, Stage_01.sch, Stage_02.sch, Stage_03.sch, Stage_04.sch, Stage_05.sch, Stage_06.sch, Stage_07.sch]
2019-09-24 Started PCB
    [Incrementor.kicad_pcb]
2019-09-24 More routing
    [Incrementor.kicad_pcb]
2019-11-21 Changed input protection circuit
    [Incrementor.kicad_pcb, POS12_Power_Input.sch, POS3P3_Power_Supply.sch]
2019-12-06 Added new power supply, more layout
    [Incrementor.kicad_pcb, Oscillator.sch, POS12_Power_Input.sch, POS3P3_Power_Supply.sch, Pushbuttons.sch]
2019-12-08 Added cap touch LDOs to make the circuit not suck
    [Incrementor.kicad_pcb, Pushbuttons.sch]
2019-12-09 Finished arranging parts, drew board outline
    [Clock_Output.sch, External_Clock.sch, Incrementor.kicad_pcb, Oscillator.sch, Pushbuttons.sch, Stage_01.sch, Stage_02.sch, Stage_03.sch]
2019-12-09 PCB arrangemnt refinements
    [Incrementor.kicad_pcb, Mechanical.sch, Pushbuttons.sch]
2019-12-10 Lots and lots of board compression. Now fits in 10cmx5cm
    [Clock_Selection.sch, Incrementor.kicad_pcb, Oscillator.sch]
2019-12-11 Started routing, fixed AND gate pinout
    [Clock_Selection.sch, Incrementor.kicad_pcb]
2019-12-12 lots more routing
    [Incrementor.kicad_pcb, POS12_Power_Input.sch]
2019-12-14 Finished first pass on routing
    [Incrementor.kicad_pcb]
2019-12-15 Added lots of PCB symbols/features
    [Incrementor.kicad_pcb]
2019-12-15 Fixed a few BOM issues
    [Clock_Output.sch, External_Clock.sch, Incrementor.kicad_pcb, Incrementor.xlsx, Oscillator.sch, POS3P3_Power_Supply.sch, Pushbuttons.sch]
2019-12-15 Fixed issues, generated gerbers
    [Incrementor-B_Cu.gbr, Incrementor-B_Mask.gbr, Incrementor-B_Paste.gbr, Incrementor-B_SilkS.gbr, Incrementor-Edge_Cuts.gbr, Incrementor-F_Cu.gbr, Incrementor-F_Mask.gbr, Incrementor-F_Paste.gbr]
2023-12-30 ported to kicad 7.0 from old project
    [Clock_Output.kicad_sch, Clock_Selection.kicad_sch, External_Clock.kicad_sch, Incrementor.kicad_sch, Incrementor.xlsx, Mechanical.kicad_sch, Oscillator.kicad_sch, Oscillator.sch]
2024-01-02 renamed project, removed stuff I dont need
    [Clock_Output.kicad_sch, Clock_Output.sch, Clock_Selection.kicad_sch, Clock_Selection.sch, External_Clock.kicad_sch, External_Clock.sch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]
2024-01-02 renamed folders
    [Clock_Output.kicad_sch, Clock_Selection.kicad_sch, External_Clock.kicad_sch, Mechanical.kicad_sch, Oscillator.kicad_sch, POS12_Power_Input.kicad_sch, POS3P3_Power_Supply.kicad_sch, Pushbuttons.kicad_sch]
2024-01-02 started sch work
    [Oscillator.kicad_sch, POS12_Power_Input.kicad_sch, POS3P3_Power_Supply.kicad_sch, Pushbuttons.kicad_sch, Stage_01.kicad_sch, Stage_02.kicad_sch, Stage_03.kicad_sch, Stage_04.kicad_sch]
2024-01-05 adjusted stage sheet
    [Mechanical.kicad_sch, Oscillator.kicad_sch, POS12_Power_Input.kicad_sch, POS3P3_Power_Supply.kicad_sch, Pushbuttons.kicad_sch, Stage_01.kicad_sch, Stage_02.kicad_sch, Stage_03.kicad_sch]
2024-01-05 added reset stuff
    [Oscillator.kicad_sch, POS12_Power_Input.kicad_sch, Pushbuttons.kicad_sch, Status_LEDs.kicad_sch, Stopwatch.kicad_sch, seconds_reset.kicad_sch]
2024-01-08 added more reset stuff
    [POS12_Power_Input.kicad_sch, seconds_reset.kicad_sch]
2024-01-08 copied to minutes reset sheet
    [POS12_Power_Input.kicad_sch, Stage_01.kicad_sch, Stopwatch.kicad_sch]
2024-01-11 added some more junk
    [Mechanical.kicad_sch, Oscillator.kicad_sch, POS12_Power_Input.kicad_sch, POS3P3_Power_Supply.kicad_sch, Pushbuttons.kicad_sch, Stage_01.kicad_sch, Stage_02.kicad_sch, Stage_03.kicad_sch]
2024-01-17 Assigned some digikey pns
    [Oscillator.kicad_sch, POS12_Power_Input.kicad_sch, POS3P3_Power_Supply.kicad_sch, Pushbuttons.kicad_sch, Stage_01.kicad_sch, Stage_02.kicad_sch, Stage_03.kicad_sch, Stage_04.kicad_sch]
2024-01-18 added ability to turn off colons
    [POS12_Power_Input.kicad_sch, Status_LEDs.kicad_sch]
2024-01-19 added proper power sequencing, discharge
    [Mechanical.kicad_sch, Oscillator.kicad_sch, POS12_Power_Input.kicad_sch, POS3P3_Power_Supply.kicad_sch, Pushbuttons.kicad_sch, Stage_01.kicad_sch, Stage_02.kicad_sch, Stage_03.kicad_sch]
2024-01-23 pulled footprints into layout
    [POS12_Power_Input.kicad_sch, Stopwatch.kicad_pcb]
2024-01-24 hid unneeded refdes in layout
    [Stopwatch.kicad_pcb]
2024-01-25 some random layout stuff
    [POS12_Power_Input.kicad_sch, Stopwatch.kicad_pcb]
2024-01-25 more component placement
    [POS12_Power_Input.kicad_sch, Stopwatch.kicad_pcb]
2024-01-27 more component placment
    [Stopwatch.kicad_pcb]
2024-01-30 lots and lots of routing
    [Oscillator.kicad_sch, POS12_Power_Input.kicad_sch, POS3P3_Power_Supply.kicad_sch, Pushbuttons.kicad_sch, Stage_01.kicad_sch, Stage_02.kicad_sch, Stage_03.kicad_sch, Stage_04.kicad_sch]
2024-01-30 got no unconnects to 0
    [Stopwatch.kicad_pcb, minutes_reset.kicad_sch, seconds_reset.kicad_sch]
2024-01-30 added some silkscreen stuff
    [Stopwatch.kicad_pcb]
2024-02-03 generated gerbers
    [POS12_Power_Input.kicad_sch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]
2024-04-16 generated rev b folder
    [Clock_Output.kicad_sch, Clock_Selection.kicad_sch, External_Clock.kicad_sch, Mechanical.kicad_sch, Oscillator.kicad_sch, POS12_Power_Input.kicad_sch, POS3P3_Power_Supply.kicad_sch, Pushbuttons.kicad_sch]
2024-04-16 ported rev b to kicad 8
    [Mechanical.kicad_sch, Oscillator.kicad_sch, POS12_Power_Input.kicad_sch, POS3P3_Power_Supply.kicad_sch, Pushbuttons.kicad_sch, Stage_01.kicad_sch, Stage_02.kicad_sch, Stage_03.kicad_sch]
2024-04-16 converted pcb to rev b
    [Stopwatch.kicad_pcb]
2024-04-16 integrated SC70 gates
    [Oscillator.kicad_sch, POS12_Power_Input.kicad_sch, Pushbuttons.kicad_sch, Status_LEDs.kicad_sch, Stopwatch.kicad_pcb, minutes_reset.kicad_sch, seconds_reset.kicad_sch]
2024-04-16 some rev B PCB progress
    [Stopwatch.kicad_pcb]
2024-04-16 moved all components into rev b board outline
    [Stopwatch.kicad_pcb]
2024-04-19 more PCB work
    [Stopwatch.kicad_pcb]
2024-04-28 finished rev B PCB
    [Mechanical.kicad_sch, Oscillator.kicad_sch, POS12_Power_Input.kicad_sch, POS3P3_Power_Supply.kicad_sch, Pushbuttons.kicad_sch, Stage_01.kicad_sch, Stage_02.kicad_sch, Stage_03.kicad_sch]
